tekki-tom/mqtt_io/i2c_messung/i2c_extender_mcp23017_messbericht.pdf

## April 21, 2023

## 1 Systemaufbau

Das System ist auf einer Experimentiersteckbrett (Breadboard) aufgebaut.
Der IO expander ist ein Microchip MCP 23017. Die Adresse ist auf 0 (0x20) festgelegt (A0 bis A2 auf GND). Die Bus-Leitungen (SCK, SDA) sind am MCP 23017 nicht mit pull ups auf VCC gezogen. Am Pico sind die internen pullup-Widerst¨ande aktiviert (siehe Listing3.)
An b0 ist ein BC550 angeschlossen, daran ein Finder 52.09.012 Relais. Das Relais ist an +12V (a0) angeschlossen, a1 ist am Kollektor des BC550 angeschlossen, der Emitter des BC550 ist an GND.
Die Tests sollen einen Einsatz als IO-Expander f¨ur einen Raspberry Pi vorbereiten. Interessante Infos sind hier: https://netzmafia.ee.hm.edu/skripten/hardware/RasPi/Projekt-I2C-Expander/index.html

## 2 Test Pi Pico

Als Testger¨at wird ein Raspberry Pi Pico W eingesetzt.
Der Extender ist an Pin 38 mit GND verbunden, Pin 36 mit 3,3V.
Das Testprogramm initialisiert den Bus i2c an den default-Pins (CSK an Pin 7 / GP5, SDA an Pin 6 / GP4).
allgemeine Inits:
in main:
Anschließend sendet das Programm die Befehlsfolge:

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

3 #i n cl u d e ” hardware / i 2 c . h”
#i n cl u d e ” pi c o / cyw43 arch . h” Listing 1: Includes (Pi Pico)

1

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

2

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

20
p r i n t f ( ” i 2 c l e d o f f r e s u l t : %d\n” , r e s u l t ) ;
22 | g pi o p u t (LED PIN , 0 ) ;
| c yw 4 3 a r c h g pi o p u t (CYW43 WL GPIO LED PIN, 0 ) ;
24 | sl e e p m s ( 1 0 0 0 ) ;
| p r i n t f ( ” bli n k \n” ) ;
26 | }
| Listing 5: Endlosschleife. Schaltet a0 und b0 zyklisch ein und aus

und initialisiert damit die Ports a und b als Ausg¨ange (alle Pins). mit printf (”i2c result : %d\n”, result); wird via Terminal ( minicom -b 115200 -o -D /dev/ttyACM0 ) die R¨uckmeldung des
i2c-Bus ausgegeben. 2 = okay, 254 = nok.
In einer Endlosschleife werden dann die Pins a0 und b0 wechselnd auf 1 und 0
gesetzt: Das Ergebnis auf dem Bus zeigt Bild 1. Im Bild sind die Register 0x12 und 0x13 adressiert, dies ist im Script in 0x14 und 0x15 korrigiert.
Der Test war ¨uberwiegend erfolgreich verlaufen. Wenn durch einen Wackelkontakt Pin SCK oder SDA unterbrochen wurde, wurde der Kontakt nicht wieder hergestellt. Es musste durch trennen der Versorgung des Pico und ca. 30 - 60 sec. Warten das System neu initialisiert werden.

### 2.1 Zweiter Test Pi Pico

Testaufbau: Sender Pi Pico, Programm wie oben. Empf¨anger: 2x MCP 23017. Ein Expander (links) auf Adr. 0x20, der andere auf Adr. Oszilloskop

3

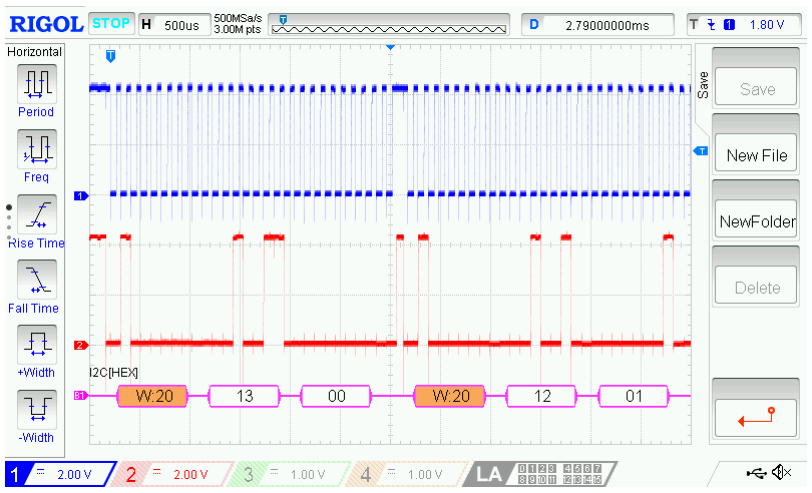
[picture p1: figure]

Figure 1: Ausgabe des I2C-Bus (Adr. 0x20, Register 0x13 und 0x12 sind im Code auf 0x15 und 0x14 korrigiert)

Kanal 1 SCK an Pico,

Kanal 2 SDA an Pico,

Kanal 3 SCK an Expander links (0x22),

Kanal 4 SDA an Expander links (0x22)

Der Expander links l¨asst sich nicht korrekt ansprechen. Das Signal am Pico ist in Ordnung, beim Signal am Expander links fehlt bei einigen Tests SCK.
Einspeisung erfolgt zuerst am Expander links. Dann am Expander rechts. Bei Einspeisung rechts ist links ist zeitweise kein SCK messbar.
Nach Vertauschen der Reihenfolge im Programm (zuerst an 0x22, dann 0x20) reagiert der Expander 0x22 auch nicht. siehe Bild 2
Bei beiden Expandern /Reset auf VCC gezogen, das behebt das Problem, von undefinierten ausf¨allen. Vorher war /Reset nicht beschaltet.

## 3 Test Pi 3b+

Als Pi wird ein Raspberry Pi 3b+ mit Raspian verwendet. Am Pi ist der i2c Bus aktiviert. zum Testen ist der Takt des i2c auf 1kHz begrenzt. Bei Messung mit dem Oszilloskop (Rigol DS 1054Z) ergibt sich, dass der Takt bei 100kHz bleibt (siehe Bild 3).

4

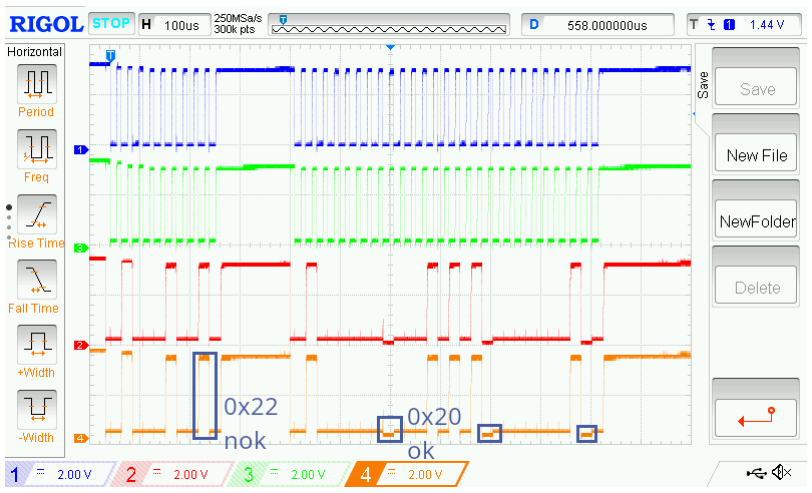
[picture p2: figure]

Figure 2: Zwei Expander. Sende Reihenfolge 0x22, dann 0x20

Ein Test mit i2cdetect =y 1 0x20 0x27 ergab folgende Situation: siehe Bild 3 An der Adresse 0x20 antwortete der IC planm¨aßig. An Adresse 0x21 kam keine Antwort (gekennzeichnet durch das ”‘?”’) danach bricht das Signal unerwartet zusammen. Diese Zusammenbr¨uche sind bei Test mit dem Raspberry Pi mehrfach festzustellen, eine Ursache ist mir noch nicht bekannt. Ein erneuter Test mit detect ergab Bild 4. Der Expander konnte die Adresse nicht dekodieren und der Detect schlug damit fehl.

5

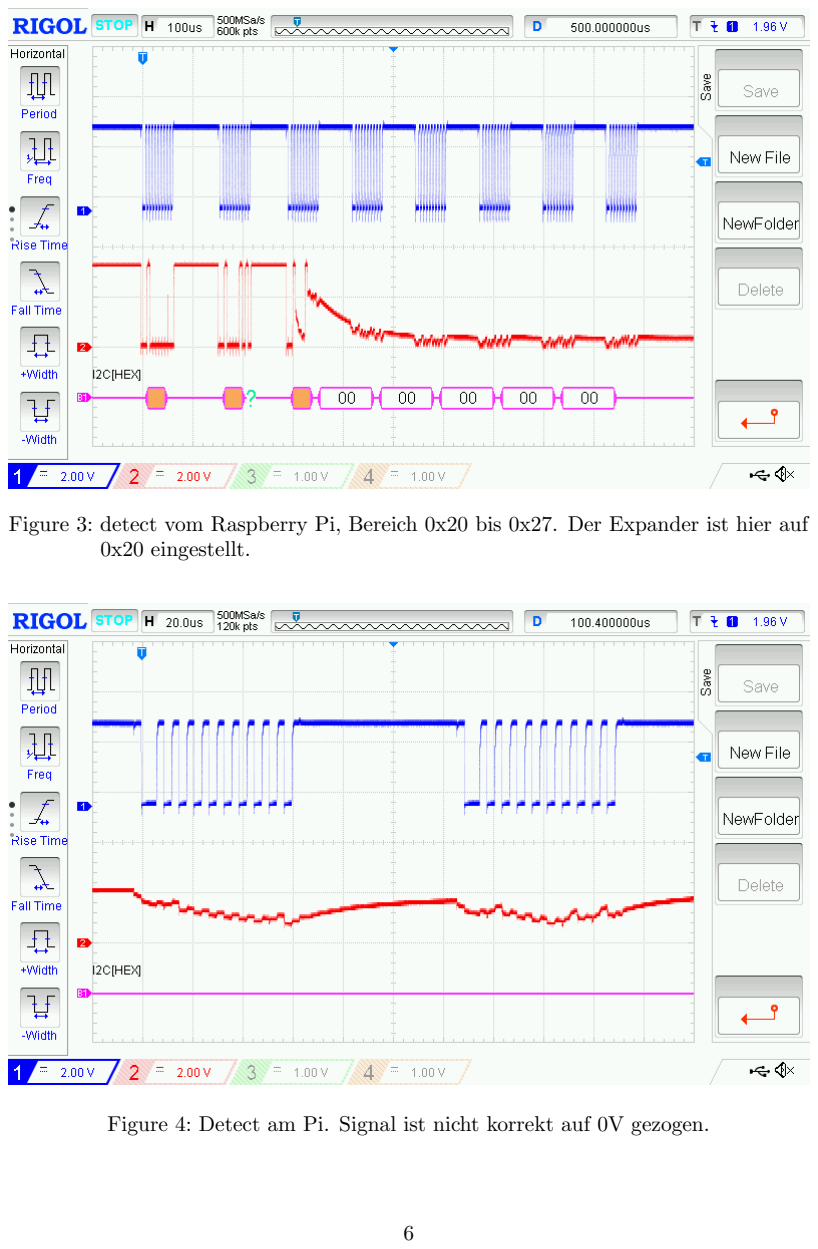
[picture p3: page 6]

Figure 3: detect vom Raspberry Pi, Bereich 0x20 bis 0x27. Der Expander ist hier auf 0x20 eingestellt.

Figure 4: Detect am Pi. Signal ist nicht korrekt auf 0V gezogen.

6
