tekki-tom/mqtt_io/mqtt_io/mqtt_out_box/mqtt_out_box_thd/mqtt_out_box_thd_sch.pdf

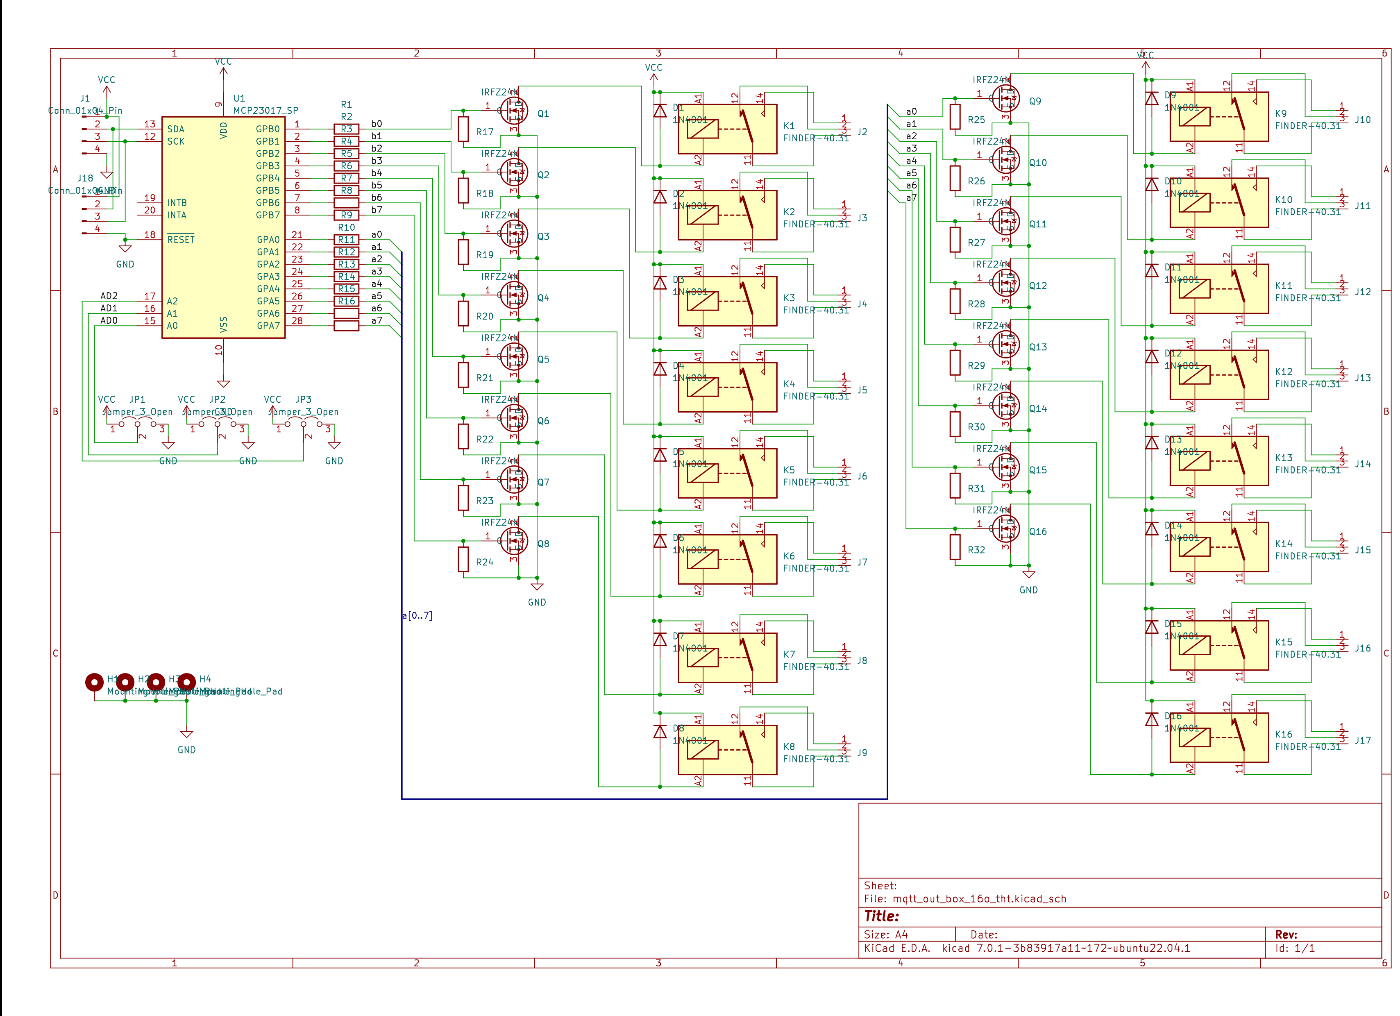
[picture p4: page 1]
