tekki-tom/mqtt_io/i2c_messung/pico_2exp_0x20_nok._mark.png

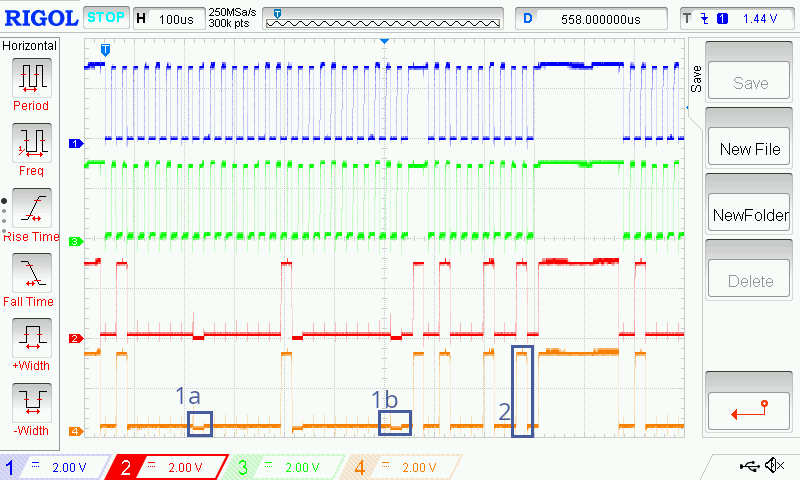
i2c_messung/pico_2exp_0x20_nok._mark.png
