tekki-tom/mqtt_io/mqtt_io/out/mqtt_out_box_16o_tht/rev2/mqtt_out_box_16o_tht_rev2.kicad_pro/todo.md

#Todos

09.09.23

* [x] Pullup-Widerstände von SCL und SDA per Jumper schaltbar machen (pullUp aktiv/inaktiv)
* [x] Prüfen ob SDA und SCL von Data in auf Data out vertauscht sind
