tekki-tom/mqtt_io/mqtt_io/mqtt_out_box/mqtt_out_box_thd/mqtt_out_box_thd_brd_parts.pdf

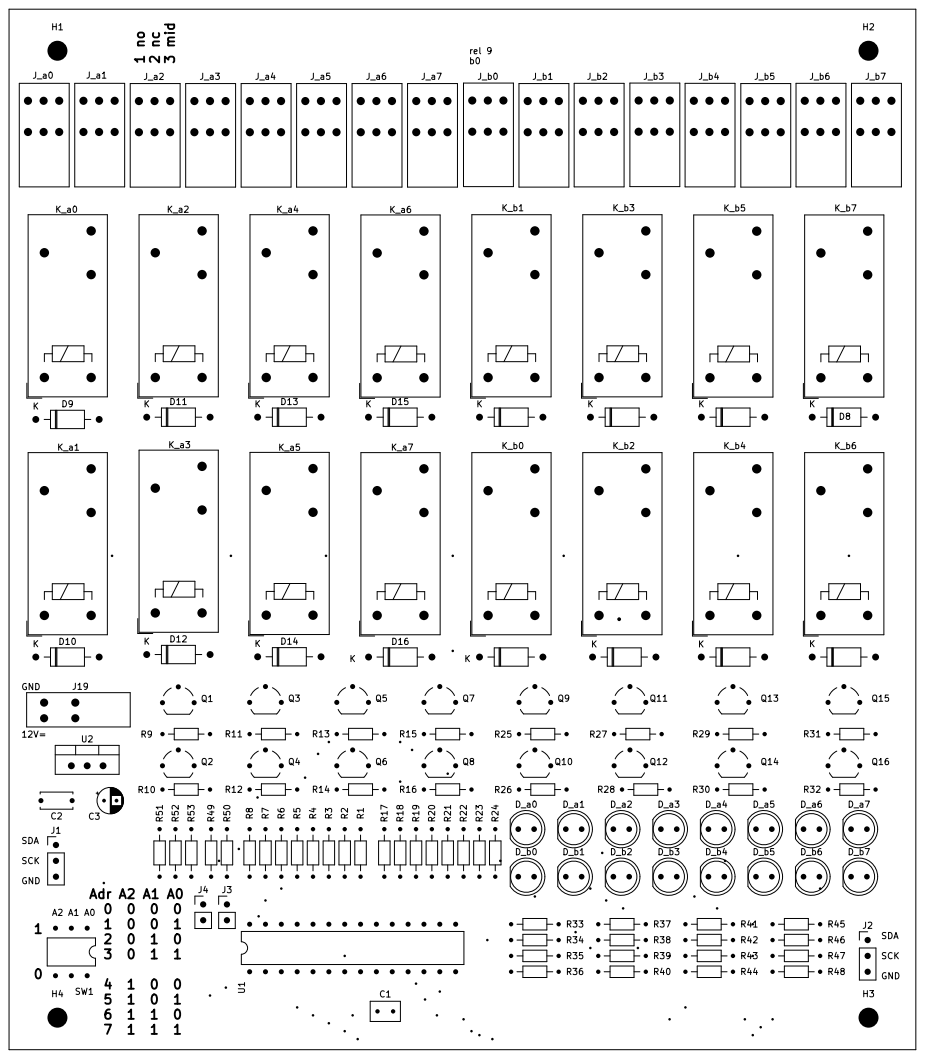
[picture p7: page 1]
