tekki-tom/mqtt_io/mqtt_io/in/mqtt_io_in_box_16i_tht_smd/mqtt_io_in_box_16i_tht_smd_schaltplan.pdf

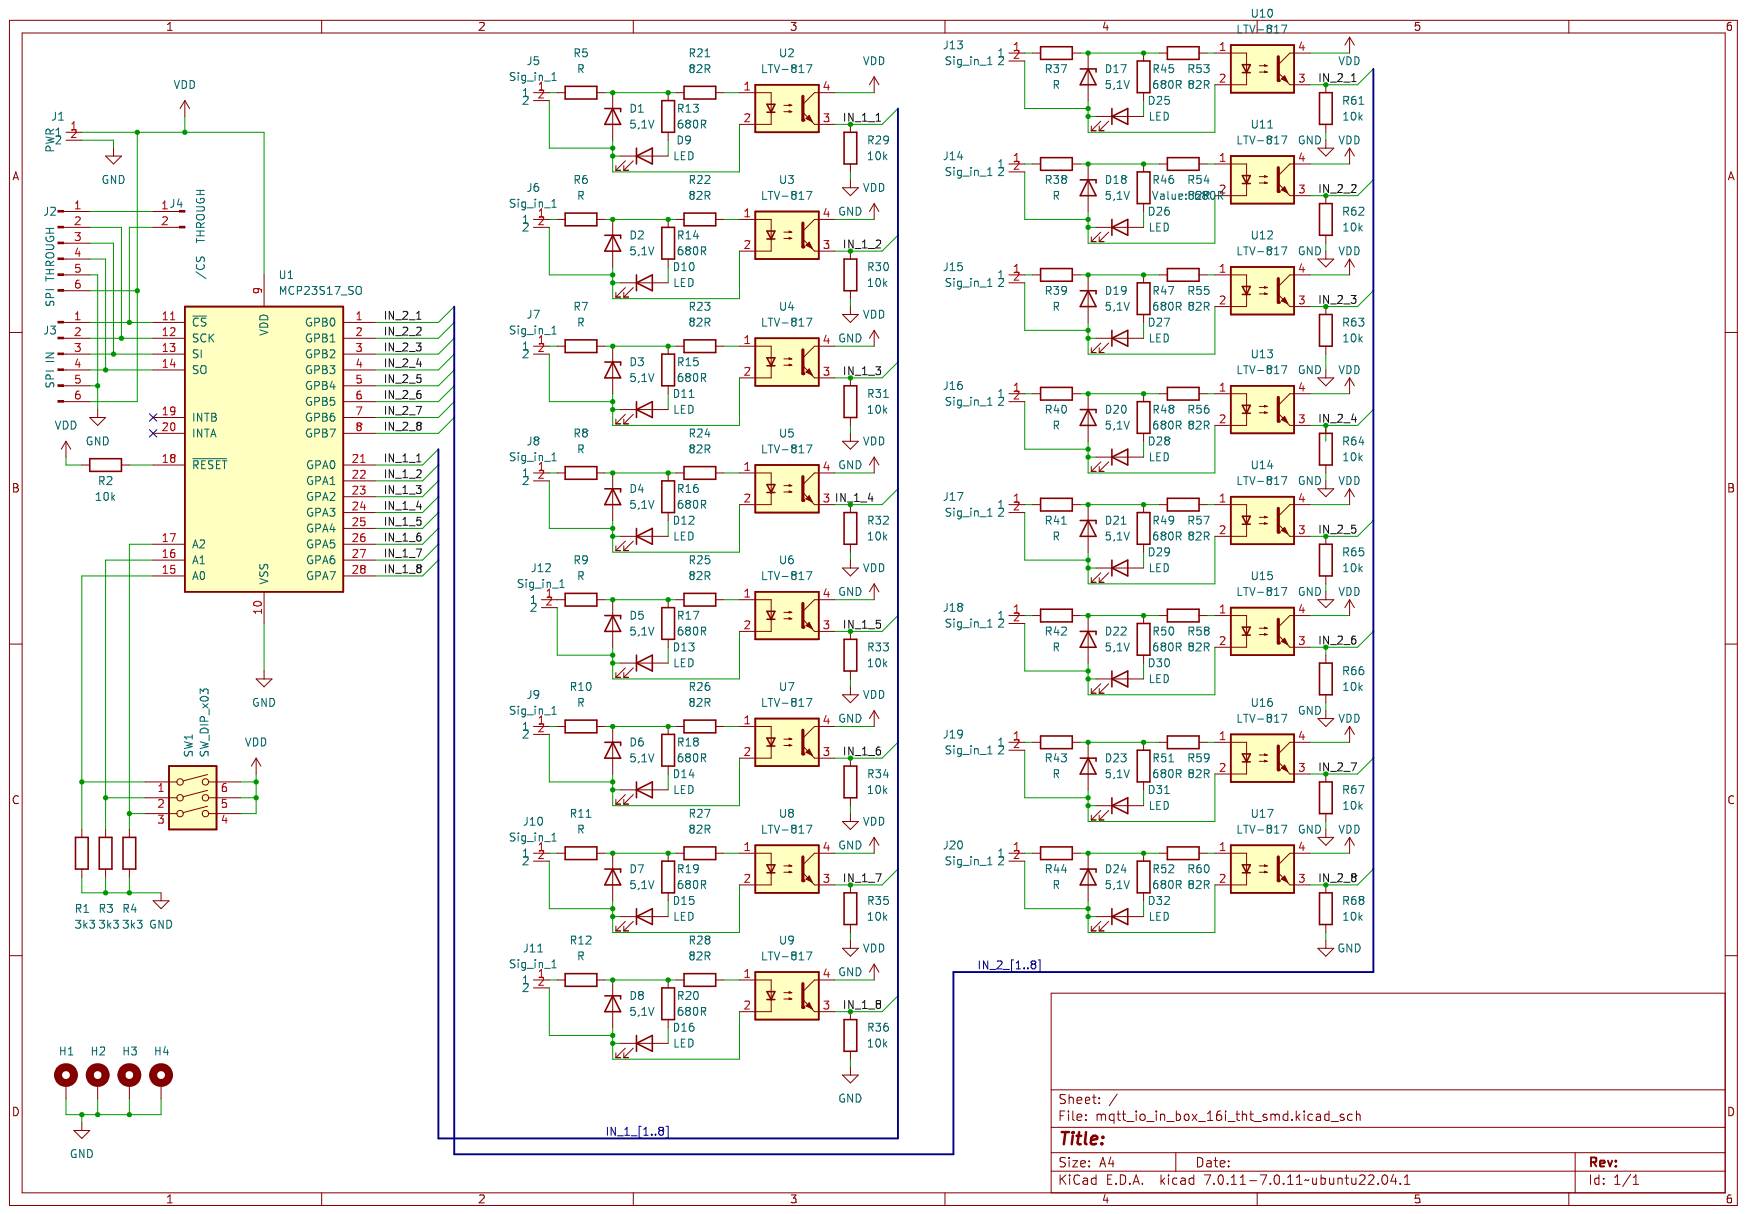
[picture p9: page 1]
