tekki-tom/mqtt_io/mqtt_io/mqtt_out_box/mqtt_out_box_thd/mqtt_out_box_thd_brd_cu_f.pdf

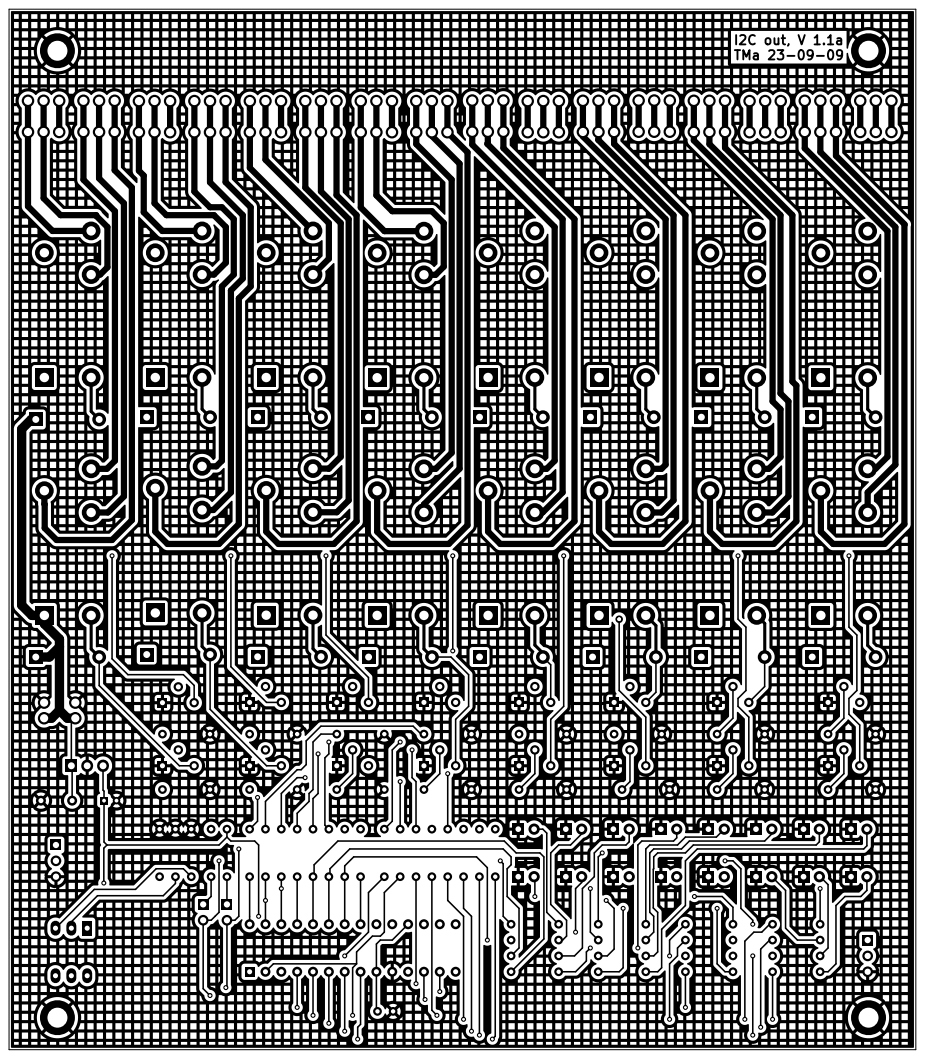
[picture p11: page 1]
