tekki-tom/mqtt_io/mqtt_io/mqtt_out_box/mqtt_out_box_thd/mqtt_out_mics_red_white_v0_1_tma.pdf

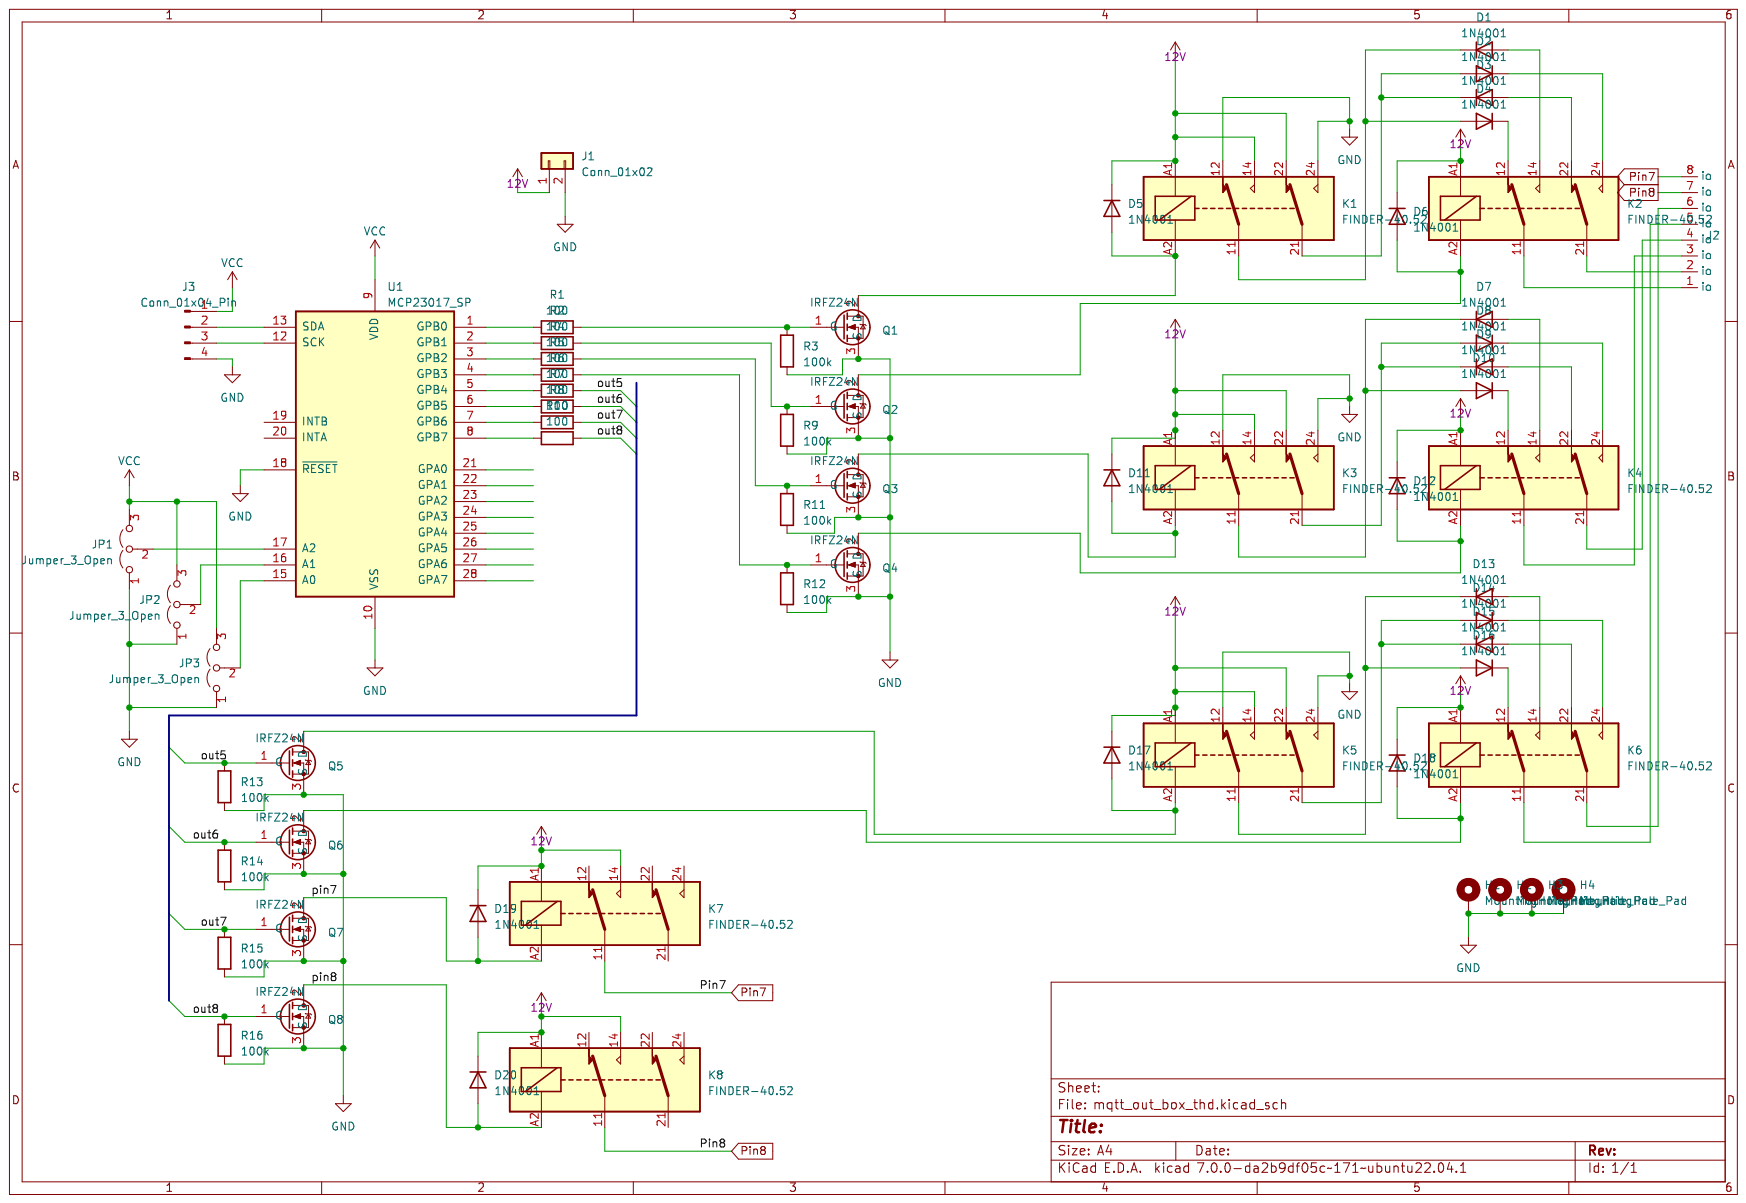
[picture p12: page 1]
