tekki-tom/mqtt_io/mqtt_io/out/mqtt_out_box_16o_tht/mqtt_out_box_16out_tht_board_cu.pdf

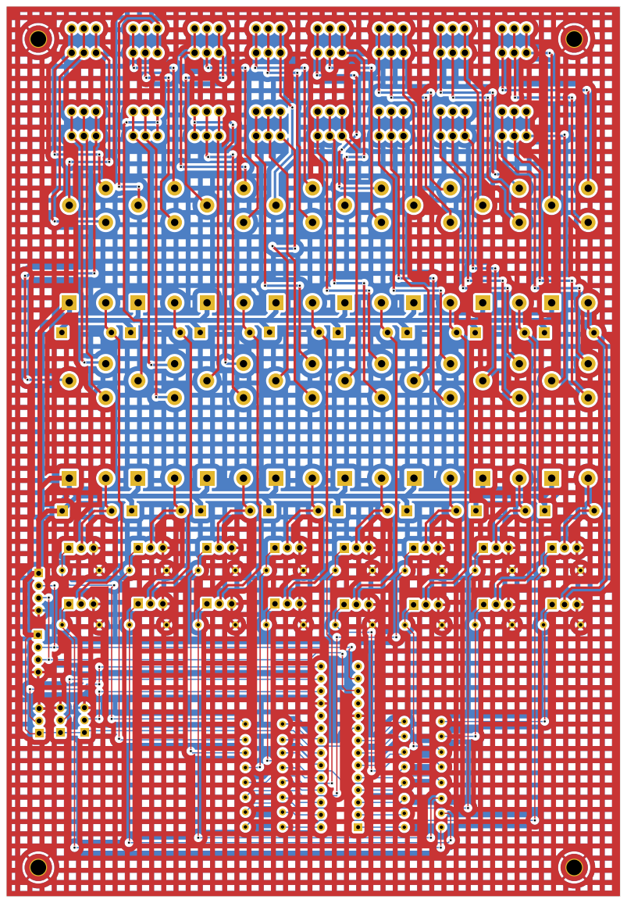
[picture p13: page 1]
