tekki-tom/mqtt_io/mqtt_io/in/mqtt_io_in_box_16i_tht_smd/mqtt_io_in_box_16i_tht_smd.kicad_pcb

## KiCad design mqtt_io/in/mqtt_io_in_box_16i_tht_smd/mqtt_io_in_box_16i_tht_smd.kicad_pcb (2024-04-09)

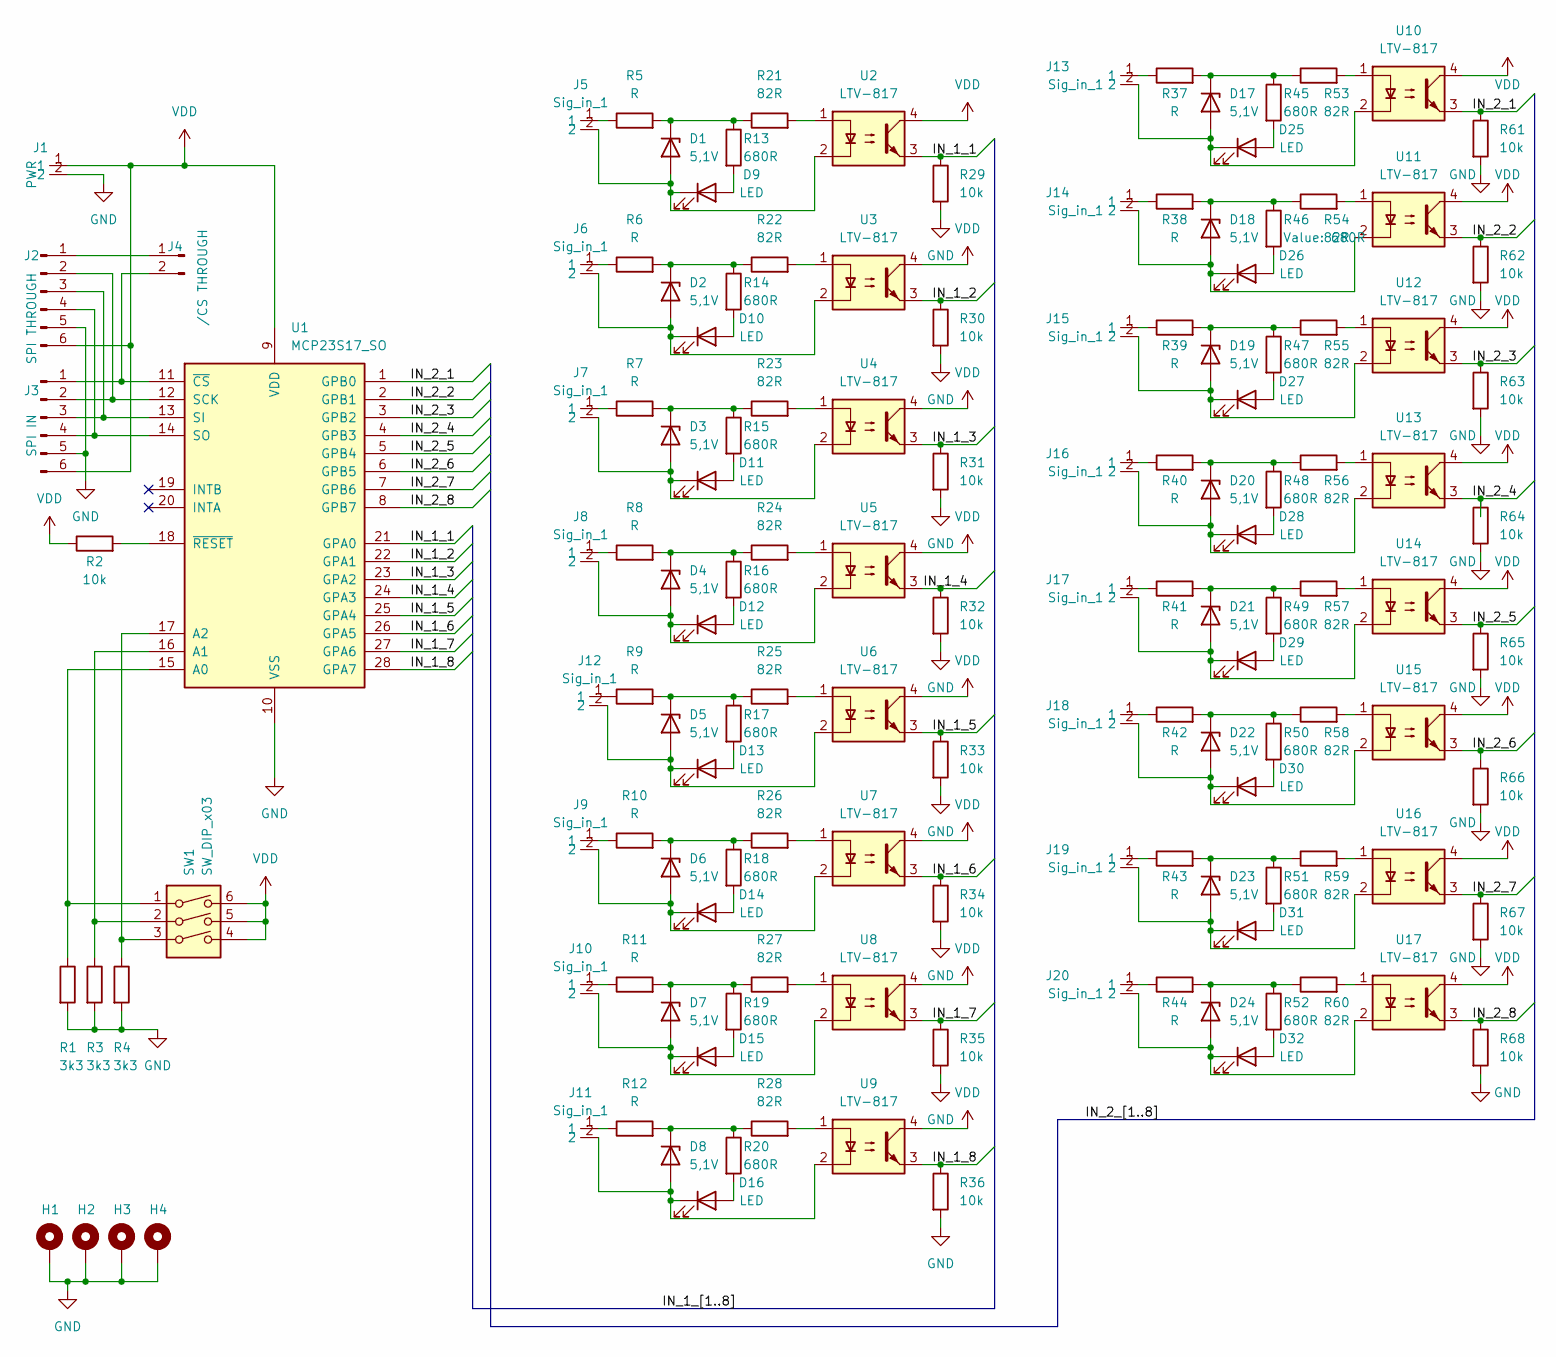
[picture p14: schematic mqtt_io_in_box_16i_tht_smd.kicad_sch]

Parts:
D1, D2, D3, D4, D5, D6, D7, D8, D17, D18, D19, D20, D21, D22, D23, D24: 5,1V; D_MiniMELF_Handsoldering
D9, D10, D11, D12, D13, D14, D15, D16, D25, D26, D27, D28, D29, D30, D31, D32: LED; LED_0805_2012Metric_Pad1.15x1.40mm_HandSolder
H1, H2, H3, H4: MountingHole_Pad; MountingHole_3.2mm_M3_DIN965_Pad_TopBottom
J1: PWR; AST_041-2
J2: SPI THROUGH; PinHeader_1x06_P2.54mm_Vertical
J3: SPI IN; PinHeader_1x06_P2.54mm_Vertical
J4: /CS THROUGH; PinHeader_1x02_P2.54mm_Vertical
J5, J6, J7, J8, J9, J10, J11, J12, J13, J14, J15, J16, J17, J18, J19, J20: Sig_in_1; AST_041-2
R1, R3, R4: 3k3; R_0805_2012Metric_Pad1.20x1.40mm_HandSolder
R2, R29, R30, R31, R32, R33, R34, R35, R36, R61, R62, R63, R64, R65, R66, R67, R68: 10k; R_0805_2012Metric_Pad1.20x1.40mm_HandSolder
R5, R6, R7, R8, R9, R10, R11, R12, R37, R38, R39, R40, R41, R42, R43, R44: R; R_0805_2012Metric_Pad1.20x1.40mm_HandSolder
R13, R14, R15, R16, R17, R18, R19, R20, R45, R46, R47, R48, R49, R50, R51, R52: 680R; R_0805_2012Metric_Pad1.20x1.40mm_HandSolder
R21, R22, R23, R24, R25, R26, R27, R28, R53, R54, R55, R56, R57, R58, R59, R60: 82R; R_0805_2012Metric_Pad1.20x1.40mm_HandSolder
SW1: SW_DIP_x03; DIP-6_W7.62mm_LongPads
U1: MCP23S17_SO; SOIC-28W_7.5x17.9mm_P1.27mm
U2, U3, U4, U5, U6, U7, U8, U9, U10, U11, U12, U13, U14, U15, U16, U17: LTV-817; DIP-4_W7.62mm

Connections:
/IN_1_1: R29.1, U1.21 (GPA0), U2.3
/IN_1_2: R30.1, U1.22 (GPA1), U3.3
/IN_1_3: R31.1, U1.23 (GPA2), U4.3
/IN_1_4: R32.1, U1.24 (GPA3), U5.3
/IN_1_5: R33.1, U1.25 (GPA4), U6.3
/IN_1_6: R34.1, U1.26 (GPA5), U7.3
/IN_1_7: R35.1, U1.27 (GPA6), U8.3
/IN_1_8: R36.1, U1.28 (GPA7), U9.3
/IN_2_1: R61.1, U1.1 (GPB0), U10.3
/IN_2_2: R62.1, U1.2 (GPB1), U11.3
/IN_2_3: R63.1, U1.3 (GPB2), U12.3
/IN_2_4: R64.1, U1.4 (GPB3), U13.3
/IN_2_5: R65.1, U1.5 (GPB4), U14.3
/IN_2_6: R66.1, U1.6 (GPB5), U15.3
/IN_2_7: R67.1, U1.7 (GPB6), U16.3
/IN_2_8: R68.1, U1.8 (GPB7), U17.3
GND: H1.1, H2.1, H3.1, H4.1, J1.2, J2.5, J3.5, R1.2, R3.2, R4.2, R29.2, R30.2, R31.2, R32.2, R33.2, R34.2, R35.2, R36.2, R61.2, R62.2, R63.2, R64.2, R65.2, R66.2, R67.2, R68.2, U1.10 (VSS)
unnamed: D1.2 (A), D9.1 (K), J5.2, U2.2
unnamed: D1.1 (K), R5.2, R13.1, R21.1
unnamed: D2.1 (K), R6.2, R14.1, R22.1
unnamed: D3.1 (K), R7.2, R15.1, R23.1
unnamed: D4.1 (K), R8.2, R16.1, R24.1
unnamed: D5.1 (K), R9.2, R17.1, R25.1
unnamed: D6.1 (K), R10.2, R18.1, R26.1
unnamed: D7.1 (K), R11.2, R19.1, R27.1
unnamed: D8.1 (K), R12.2, R20.1, R28.1
unnamed: D9.2 (A), R13.2
unnamed: D10.2 (A), R14.2
unnamed: D2.2 (A), D10.1 (K), J6.2, U3.2
unnamed: D11.2 (A), R15.2
unnamed: D3.2 (A), D11.1 (K), J7.2, U4.2
unnamed: D12.2 (A), R16.2
unnamed: D4.2 (A), D12.1 (K), J8.2, U5.2
unnamed: D13.2 (A), R17.2
unnamed: D5.2 (A), D13.1 (K), J12.2, U6.2
unnamed: D14.2 (A), R18.2
unnamed: D6.2 (A), D14.1 (K), J9.2, U7.2
unnamed: D15.2 (A), R19.2
unnamed: D7.2 (A), D15.1 (K), J10.2, U8.2
unnamed: D16.2 (A), R20.2
unnamed: D8.2 (A), D16.1 (K), J11.2, U9.2
unnamed: D17.2 (A), D25.1 (K), J13.2, U10.2
unnamed: D17.1 (K), R37.2, R45.1, R53.1
unnamed: D18.2 (A), D26.1 (K), J14.2, U11.2
unnamed: D18.1 (K), R38.2, R46.1, R54.1
unnamed: D19.2 (A), D27.1 (K), J15.2, U12.2
unnamed: D19.1 (K), R39.2, R47.1, R55.1
unnamed: D20.2 (A), D28.1 (K), J16.2, U13.2
unnamed: D20.1 (K), R40.2, R48.1, R56.1
unnamed: D21.2 (A), D29.1 (K), J17.2, U14.2
unnamed: D21.1 (K), R41.2, R49.1, R57.1
unnamed: D22.2 (A), D30.1 (K), J18.2, U15.2
unnamed: D22.1 (K), R42.2, R50.1, R58.1
unnamed: D23.2 (A), D31.1 (K), J19.2, U16.2
unnamed: D23.1 (K), R43.2, R51.1, R59.1
unnamed: D24.2 (A), D32.1 (K), J20.2, U17.2
unnamed: D24.1 (K), R44.2, R52.1, R60.1
unnamed: D25.2 (A), R45.2
unnamed: D26.2 (A), R46.2
unnamed: D27.2 (A), R47.2
unnamed: D28.2 (A), R48.2
unnamed: D29.2 (A), R49.2
unnamed: D30.2 (A), R50.2
unnamed: D31.2 (A), R51.2
unnamed: D32.2 (A), R52.2
unnamed: J2.1, J4.1
unnamed: J2.2, J3.2, U1.12 (SCK)
unnamed: J2.3, J3.3, U1.13 (SI)
unnamed: J2.4, J3.4, U1.14 (SO)
unnamed: J3.1, J4.2, U1.11 (~CS)
unnamed: J5.1, R5.1
unnamed: J6.1, R6.1
unnamed: J7.1, R7.1
unnamed: J8.1, R8.1
unnamed: J9.1, R10.1
unnamed: J10.1, R11.1
unnamed: J11.1, R12.1
unnamed: J12.1, R9.1
unnamed: J13.1, R37.1
unnamed: J14.1, R38.1
unnamed: J15.1, R39.1
unnamed: J16.1, R40.1
unnamed: J17.1, R41.1
unnamed: J18.1, R42.1
unnamed: J19.1, R43.1
unnamed: J20.1, R44.1
unnamed: R21.2, U2.1
unnamed: R22.2, U3.1
unnamed: R23.2, U4.1
unnamed: R24.2, U5.1
unnamed: R25.2, U6.1
unnamed: R26.2, U7.1
unnamed: R27.2, U8.1
unnamed: R28.2, U9.1
unnamed: R53.2, U10.1
unnamed: R54.2, U11.1
unnamed: R55.2, U12.1
unnamed: R56.2, U13.1
unnamed: R57.2, U14.1
unnamed: R58.2, U15.1
unnamed: R59.2, U16.1
unnamed: R60.2, U17.1
unnamed: R1.1, SW1.1, U1.15 (A0)
unnamed: R3.1, SW1.2, U1.16 (A1)
unnamed: R4.1, SW1.3, U1.17 (A2)
unnamed: R2.2, U1.18 (~RESET)
VDD: J1.1, J2.6, J3.6, R2.1, SW1.4, SW1.5, SW1.6, U1.9 (VDD), U2.4, U3.4, U4.4, U5.4, U6.4, U7.4, U8.4, U9.4, U10.4, U11.4, U12.4, U13.4, U14.4, U15.4, U16.4, U17.4

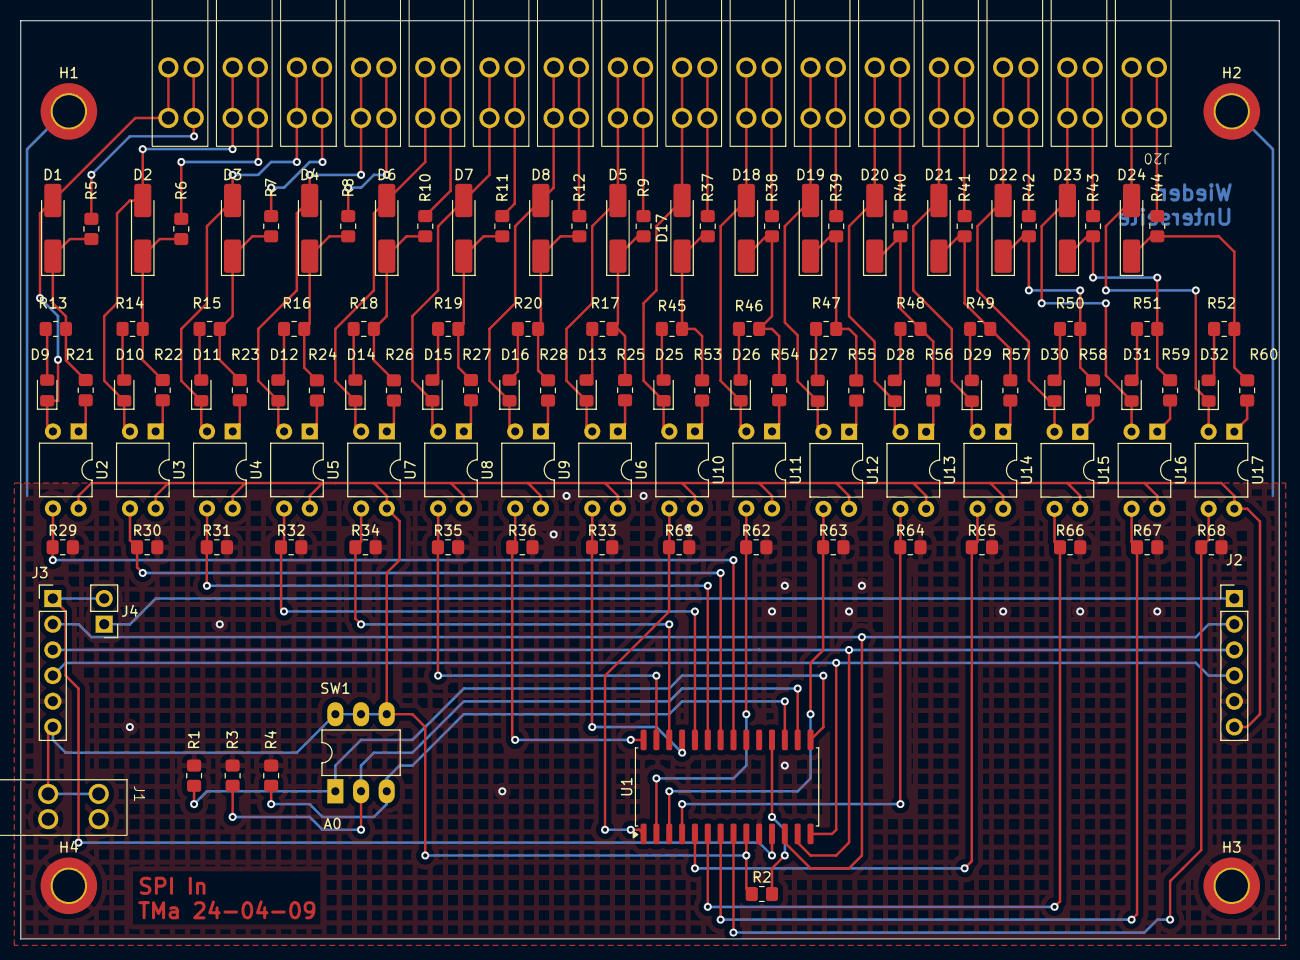
[picture p15: board mqtt_io_in_box_16i_tht_smd.kicad_pcb from above]

Board: 2 copper layers, 124.5 x 90.8 mm, 142 parts (0 on the bottom side), 107 nets.
