tekki-tom/mqtt_io/mqtt_io/mqtt_out_box/mqtt_out_box_thd/mqtt_out_box_thd.kicad_pcb

## KiCad design mqtt_io/mqtt_out_box/mqtt_out_box_thd/mqtt_out_box_thd.kicad_pcb (2023-04-23)

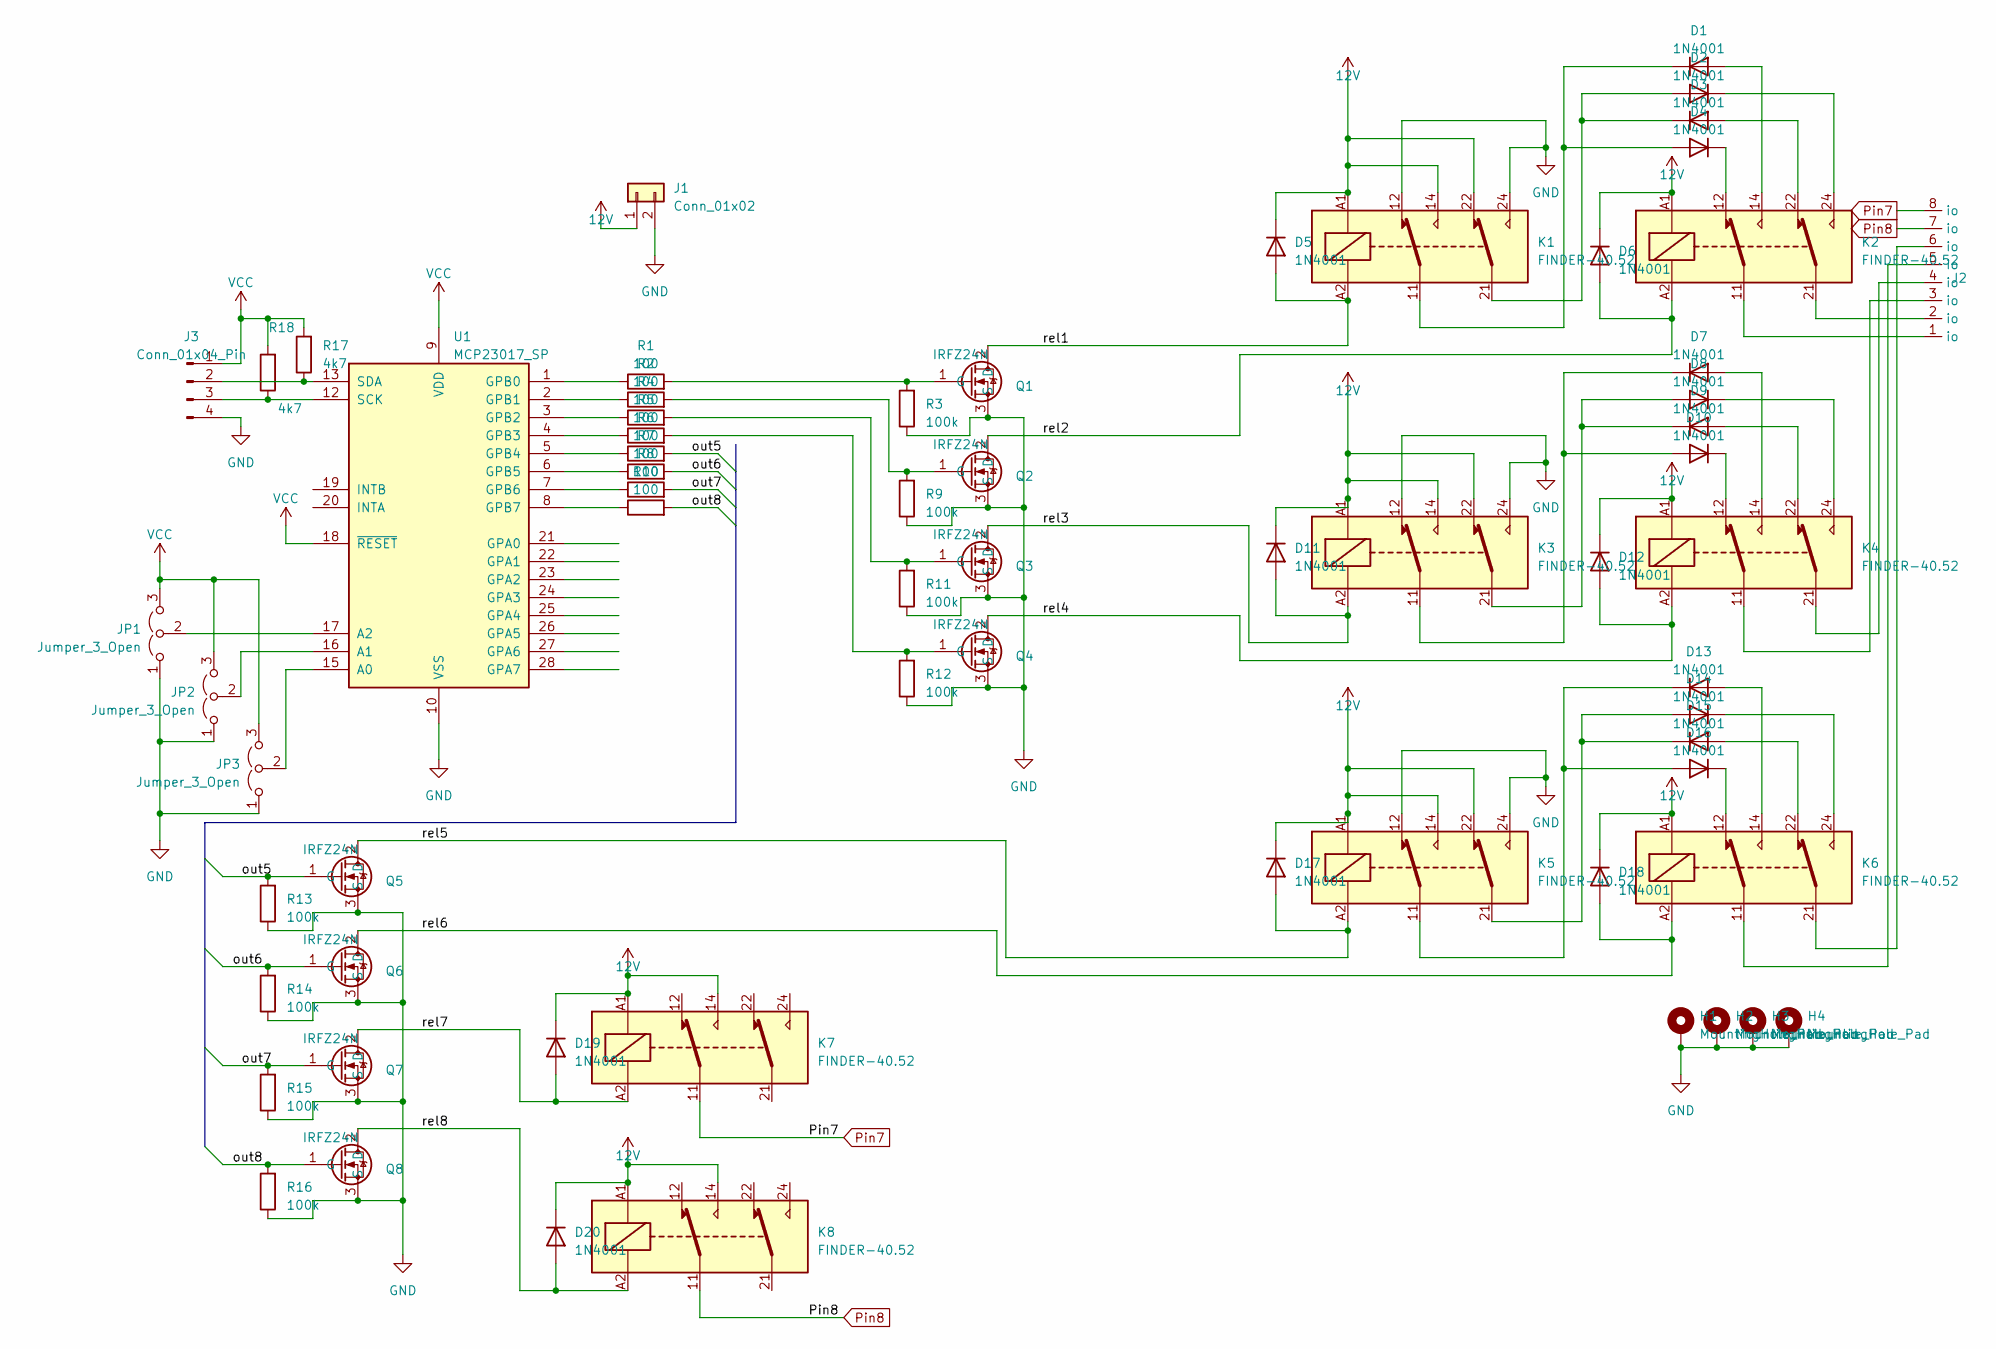
[picture p16: schematic mqtt_out_box_thd.kicad_sch]

Parts:
D1, D2, D3, D4, D5, D6, D7, D8, D9, D10, D11, D12, D13, D14, D15, D16, D17, D18, D19, D20: 1N4001; D_DO-41_SOD81_P10.16mm_Horizontal
H1, H2, H3, H4: MountingHole_Pad; MountingHole_3.2mm_M3_ISO7380_Pad_TopBottom
J1: Conn_01x02; PinHeader_1x02_P2.54mm_Vertical
J2: AST041-08
J3: Conn_01x04_Pin; PinHeader_1x04_P2.54mm_Vertical
JP1, JP2, JP3: Jumper_3_Open; PinHeader_1x03_P2.54mm_Vertical
K1, K2, K3, K4, K5, K6, K7, K8: FINDER-40.52; Relay_DPDT_Finder_40.52
Q1, Q2, Q3, Q4, Q5, Q6, Q7, Q8: IRFZ24N; TO-220-3_Vertical
R1, R2, R4, R5, R6, R7, R8, R10: 100; R_Axial_DIN0204_L3.6mm_D1.6mm_P7.62mm_Horizontal
R3, R9, R11, R12, R13, R14, R15, R16: 100k; R_Axial_DIN0204_L3.6mm_D1.6mm_P7.62mm_Horizontal
R17, R18: 4k7; R_Axial_DIN0204_L3.6mm_D1.6mm_P7.62mm_Horizontal
U1: MCP23017_SP; DIP-28_W7.62mm

Connections:
/out5: Q5.1 (G), R6.2, R13.2
/out6: Q6.1 (G), R7.2, R14.2
/out7: Q7.1 (G), R8.2, R15.2
/out8: Q8.1 (G), R10.2, R16.2
/rel1: D5.2 (A), K1.A2, Q1.2 (D)
/rel2: D6.2 (A), K2.A2, Q2.2 (D)
/rel3: D11.2 (A), K3.A2, Q3.2 (D)
/rel4: D12.2 (A), K4.A2, Q4.2 (D)
/rel5: D17.2 (A), K5.A2, Q5.2 (D)
/rel6: D18.2 (A), K6.A2, Q6.2 (D)
/rel7: D19.2 (A), K7.A2, Q7.2 (D)
/rel8: D20.2 (A), K8.A2, Q8.2 (D)
GND: H1.1, H2.1, H3.1, H4.1, J1.2, J3.4, JP1.1 (A), JP2.1 (A), JP3.1 (A), K1.12, K1.24, K3.12, K3.24, K5.12, K5.24, Q1.3 (S), Q2.3 (S), Q3.3 (S), Q4.3 (S), Q5.3 (S), Q6.3 (S), Q7.3 (S), Q8.3 (S), R3.1, R9.1, R11.1, R12.1, R13.1, R14.1, R15.1, R16.1, U1.10 (VSS)
unnamed: D1.2 (A), K2.14
unnamed: D1.1 (K), D4.2 (A), K1.11
unnamed: D2.2 (A), D3.1 (K), K1.21
unnamed: D2.1 (K), K2.24
unnamed: D3.2 (A), K2.22
unnamed: D4.1 (K), K2.12
unnamed: D7.2 (A), K4.14
unnamed: D8.2 (A), D9.1 (K), K3.21
unnamed: D8.1 (K), K4.24
unnamed: D9.2 (A), K4.22
unnamed: D7.1 (K), D10.2 (A), K3.11
unnamed: D10.1 (K), K4.12
unnamed: D13.2 (A), K6.14
unnamed: D13.1 (K), D16.2 (A), K5.11
unnamed: D14.2 (A), D15.1 (K), K5.21
unnamed: D14.1 (K), K6.24
unnamed: D15.2 (A), K6.22
unnamed: D16.1 (K), K6.12
unnamed: J2.1 (io), K2.11
unnamed: J2.2 (io), K2.21
unnamed: J2.3 (io), K4.11
unnamed: J2.4 (io), K4.21
unnamed: J2.5 (io), K6.11
unnamed: J2.6 (io), K6.21
unnamed: J3.2, R17.1, U1.13 (SDA)
unnamed: J3.3, R18.1, U1.12 (SCK)
unnamed: JP1.2 (C), U1.17 (A2)
unnamed: JP2.2 (C), U1.16 (A1)
unnamed: JP3.2 (C), U1.15 (A0)
unnamed: Q1.1 (G), R1.2, R3.2
unnamed: Q2.1 (G), R2.2, R9.2
unnamed: Q3.1 (G), R4.2, R11.2
unnamed: Q4.1 (G), R5.2, R12.2
unnamed: R1.1, U1.1 (GPB0)
unnamed: R2.1, U1.2 (GPB1)
unnamed: R4.1, U1.3 (GPB2)
unnamed: R5.1, U1.4 (GPB3)
unnamed: R6.1, U1.5 (GPB4)
unnamed: R7.1, U1.6 (GPB5)
unnamed: R8.1, U1.7 (GPB6)
unnamed: R10.1, U1.8 (GPB7)
Pin7: J2.8 (io), K7.11
Pin8: J2.7 (io), K8.11
VCC: J3.1, JP1.3 (B), JP2.3 (B), JP3.3 (B), R17.2, R18.2, U1.9 (VDD), U1.18 (~RESET)
VCCQ: D5.1 (K), D6.1 (K), D11.1 (K), D12.1 (K), D17.1 (K), D18.1 (K), D19.1 (K), D20.1 (K), J1.1, K1.14, K1.22, K1.A1, K2.A1, K3.14, K3.22, K3.A1, K4.A1, K5.14, K5.22, K5.A1, K6.A1, K7.14, K7.A1, K8.14, K8.A1

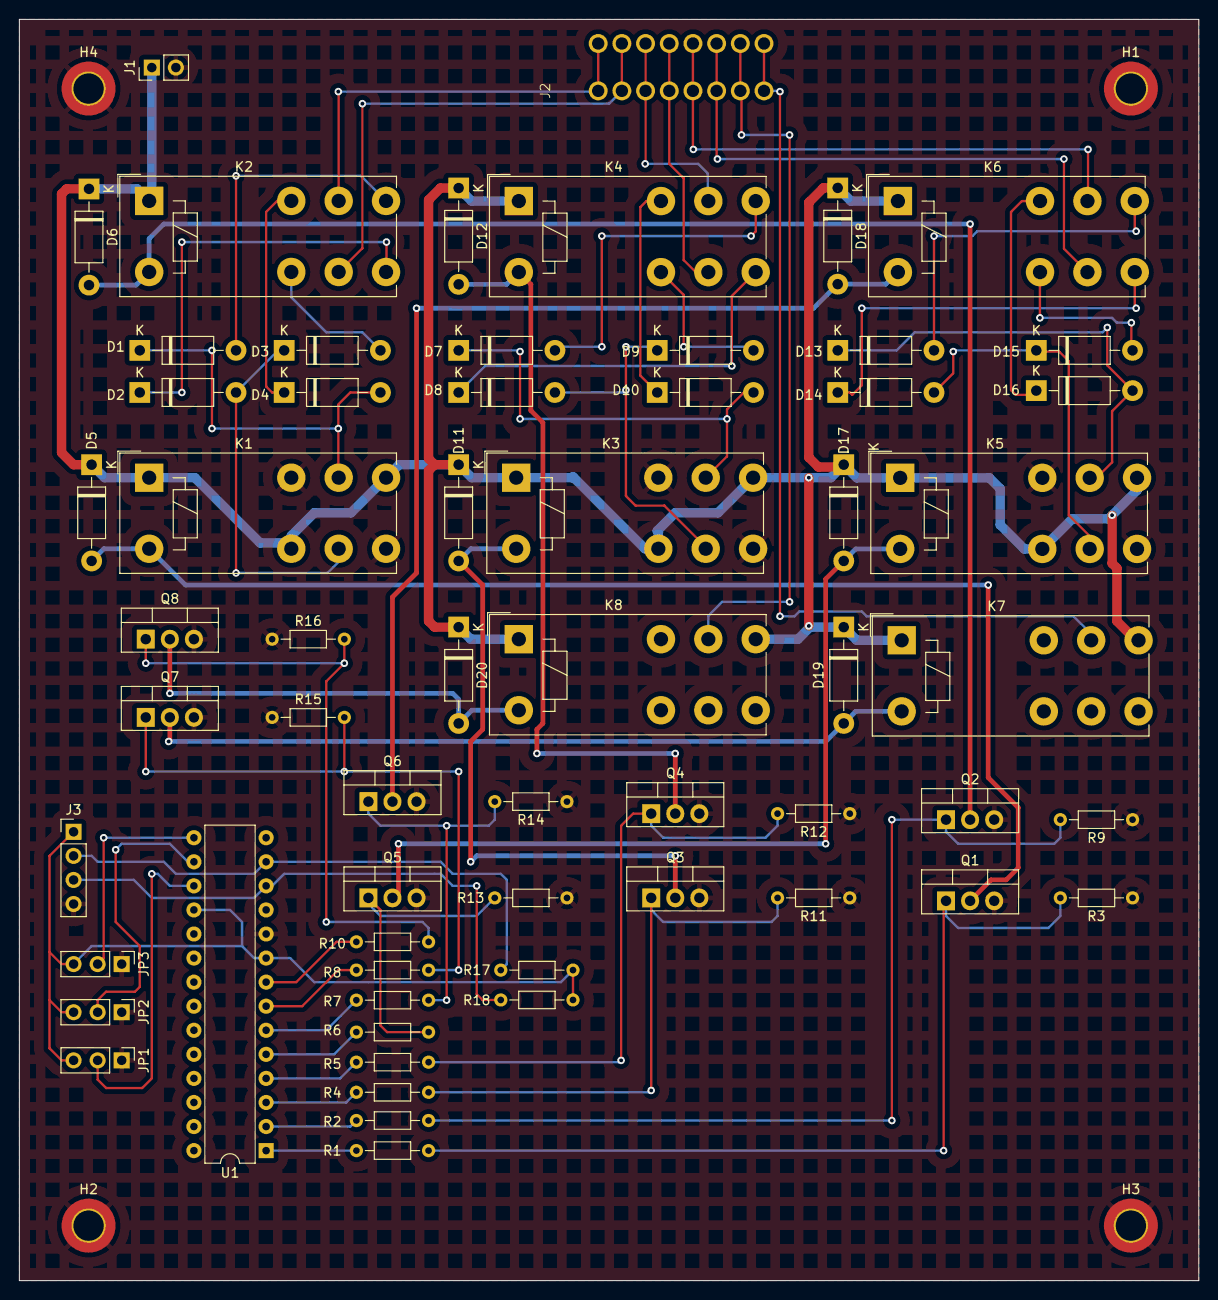
[picture p17: board mqtt_out_box_thd.kicad_pcb from above]

Board: 2 copper layers, 124.5 x 133.1 mm, 65 parts (0 on the bottom side), 58 nets.
