tekki-tom/mqtt_io/mqtt_io/out/mqtt_out_box_16o_smd/mqtt_out_box_16o.kicad_pcb

## KiCad design mqtt_io/out/mqtt_out_box_16o_smd/mqtt_out_box_16o.kicad_pcb (2023-04-23)

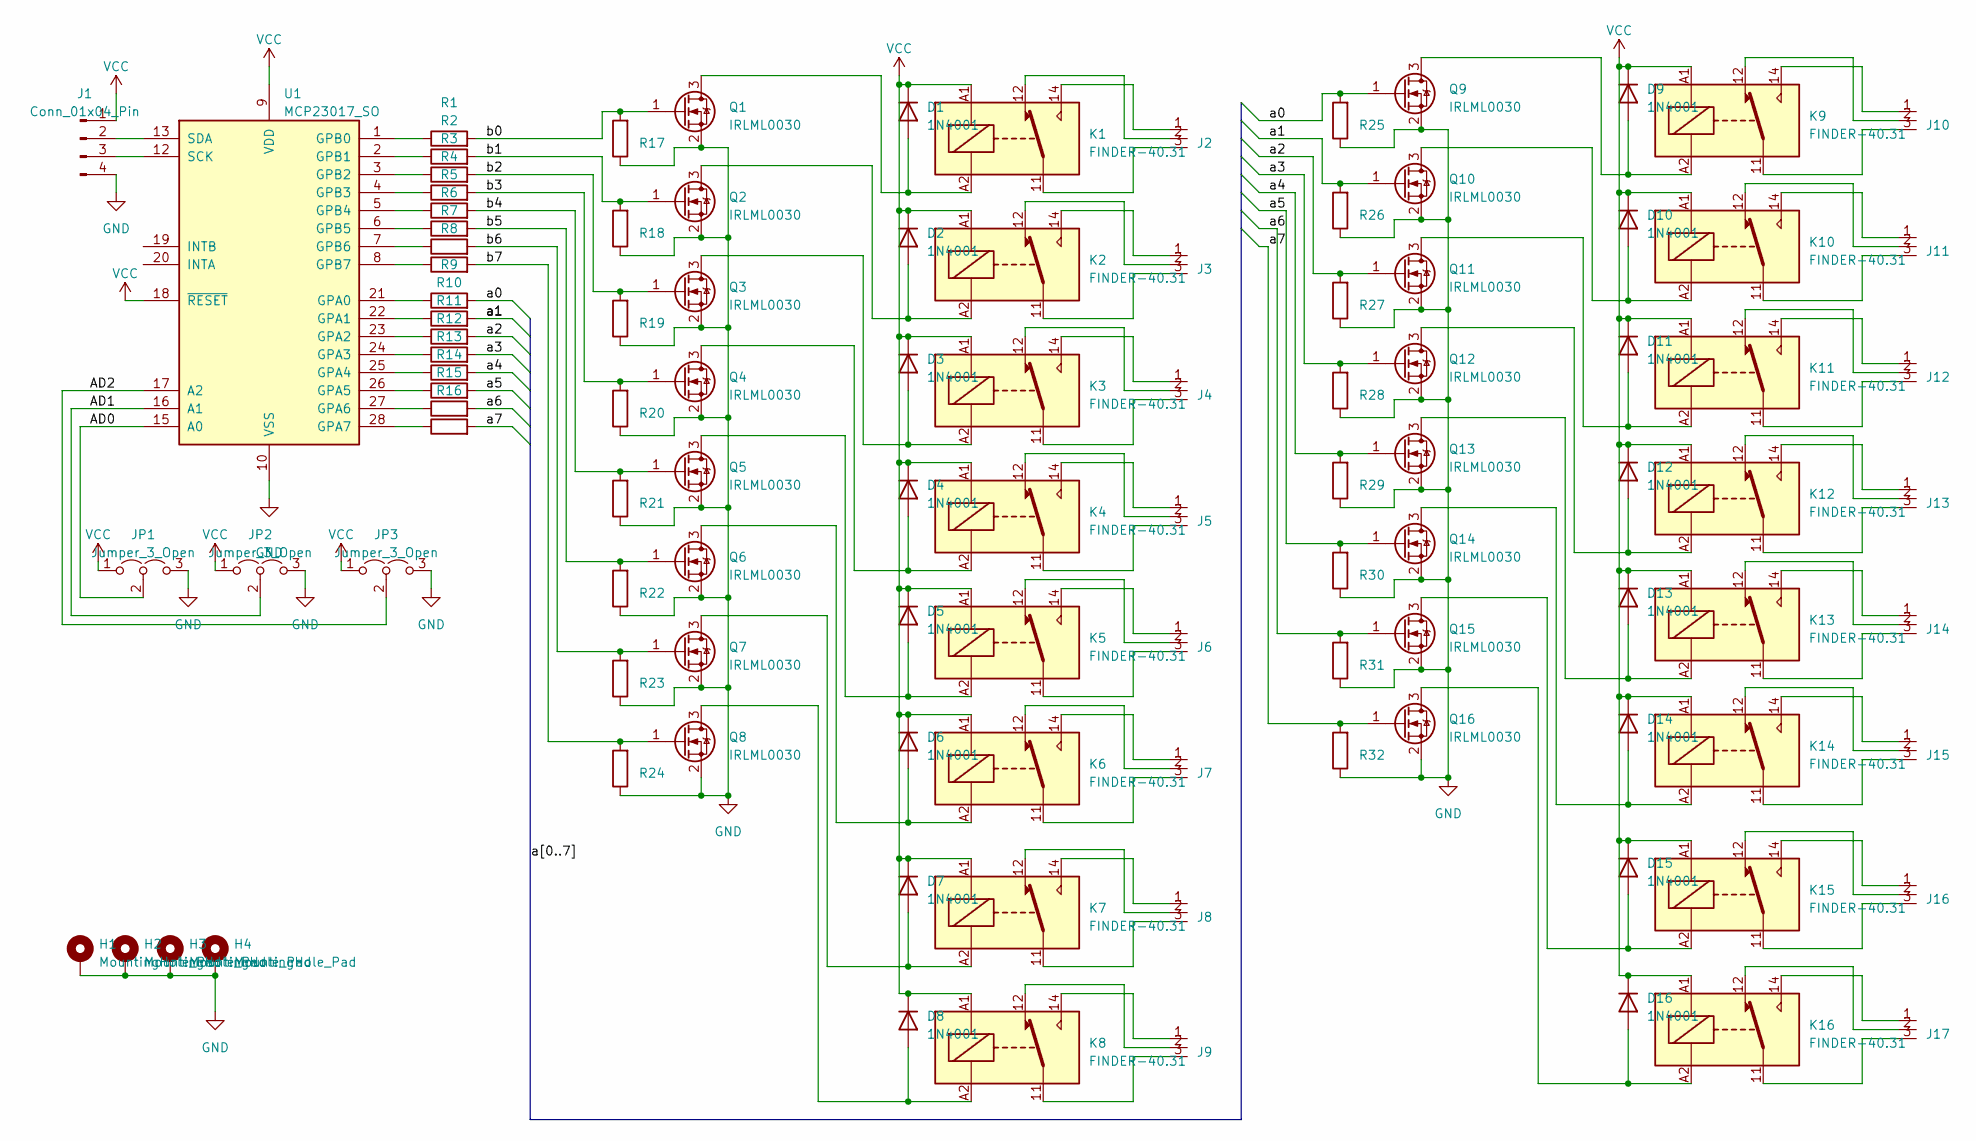
[picture p18: schematic mqtt_out_box_16o.kicad_sch]

Parts:
D1, D2, D3, D4, D5, D6, D7, D8, D9, D10, D11, D12, D13, D14, D15, D16: 1N4001; D_DO-41_SOD81_P10.16mm_Horizontal
H1, H2, H3, H4: MountingHole_Pad; MountingHole_3.2mm_M3_DIN965_Pad_TopBottom
J1: Conn_01x04_Pin; PinHeader_1x04_P2.54mm_Vertical
J2, J3, J4, J5, J6, J7, J8, J9, J10, J11, J12, J13, J14, J15, J16, J17: AST_041-3
JP1, JP2, JP3: Jumper_3_Open; PinHeader_1x03_P2.54mm_Vertical
K1, K2, K3, K4, K5, K6, K7, K8, K9, K10, K11, K12, K13, K14, K15, K16: FINDER-40.31; Relay_SPDT_Finder_40.31
Q1, Q2, Q3, Q4, Q5, Q6, Q7, Q8, Q9, Q10, Q11, Q12, Q13, Q14, Q15, Q16: IRLML0030; SOT-23
R1, R2, R3, R4, R5, R6, R7, R8, R9, R10, R11, R12, R13, R14, R15, R16: 100R; R_1206_3216Metric_Pad1.30x1.75mm_HandSolder
R17, R18, R19, R20, R21, R22, R23, R24, R25, R26, R27, R28, R29, R30, R31, R32: 100kR; R_1206_3216Metric_Pad1.30x1.75mm_HandSolder
U1: MCP23017_SO; SOIC-28W_7.5x17.9mm_P1.27mm

Connections:
/AD0: JP1.2 (C), U1.15 (A0)
/AD1: JP2.2 (C), U1.16 (A1)
/AD2: JP3.2 (C), U1.17 (A2)
/a0: Q9.1 (G), R9.2, R25.2
/a1: Q10.1 (G), R10.2, R26.2
/a2: Q11.1 (G), R11.2, R27.2
/a3: Q12.1 (G), R12.2, R28.2
/a4: Q13.1 (G), R13.2, R29.2
/a5: Q14.1 (G), R14.2, R30.2
/a6: Q15.1 (G), R15.2, R31.2
/a7: Q16.1 (G), R16.2, R32.2
/b0: Q1.1 (G), R1.2, R17.2
/b1: Q2.1 (G), R2.2, R18.2
/b2: Q3.1 (G), R3.2, R19.2
/b3: Q4.1 (G), R4.2, R20.2
/b4: Q5.1 (G), R5.2, R21.2
/b5: Q6.1 (G), R6.2, R22.2
/b6: Q7.1 (G), R7.2, R23.2
/b7: Q8.1 (G), R8.2, R24.2
GND: H1.1, H2.1, H3.1, H4.1, J1.4, JP1.3 (B), JP2.3 (B), JP3.3 (B), Q1.2 (S), Q2.2 (S), Q3.2 (S), Q4.2 (S), Q5.2 (S), Q6.2 (S), Q7.2 (S), Q8.2 (S), Q9.2 (S), Q10.2 (S), Q11.2 (S), Q12.2 (S), Q13.2 (S), Q14.2 (S), Q15.2 (S), Q16.2 (S), R17.1, R18.1, R19.1, R20.1, R21.1, R22.1, R23.1, R24.1, R25.1, R26.1, R27.1, R28.1, R29.1, R30.1, R31.1, R32.1, U1.10 (VSS)
unnamed: D1.2 (A), K1.A2, Q1.3 (D)
unnamed: D2.2 (A), K2.A2, Q2.3 (D)
unnamed: D3.2 (A), K3.A2, Q3.3 (D)
unnamed: D4.2 (A), K4.A2, Q4.3 (D)
unnamed: D5.2 (A), K5.A2, Q5.3 (D)
unnamed: D6.2 (A), K6.A2, Q6.3 (D)
unnamed: D7.2 (A), K7.A2, Q7.3 (D)
unnamed: D8.2 (A), K8.A2, Q8.3 (D)
unnamed: D9.2 (A), K9.A2, Q9.3 (D)
unnamed: D10.2 (A), K10.A2, Q10.3 (D)
unnamed: D11.2 (A), K11.A2, Q11.3 (D)
unnamed: D12.2 (A), K12.A2, Q12.3 (D)
unnamed: D13.2 (A), K13.A2, Q13.3 (D)
unnamed: D14.2 (A), K14.A2, Q14.3 (D)
unnamed: D15.2 (A), K15.A2, Q15.3 (D)
unnamed: D16.2 (A), K16.A2, Q16.3 (D)
unnamed: J1.2, U1.13 (SDA)
unnamed: J1.3, U1.12 (SCK)
unnamed: J2.1, K1.14
unnamed: J2.2, K1.12
unnamed: J2.3, K1.11
unnamed: J3.1, K2.14
unnamed: J3.2, K2.12
unnamed: J3.3, K2.11
unnamed: J4.1, K3.14
unnamed: J4.2, K3.12
unnamed: J4.3, K3.11
unnamed: J5.1, K4.14
unnamed: J5.2, K4.12
unnamed: J5.3, K4.11
unnamed: J6.1, K5.14
unnamed: J6.2, K5.12
unnamed: J6.3, K5.11
unnamed: J7.1, K6.14
unnamed: J7.2, K6.12
unnamed: J7.3, K6.11
unnamed: J8.1, K7.14
unnamed: J8.2, K7.12
unnamed: J8.3, K7.11
unnamed: J9.1, K8.14
unnamed: J9.2, K8.12
unnamed: J9.3, K8.11
unnamed: J10.1, K9.14
unnamed: J10.2, K9.12
unnamed: J10.3, K9.11
unnamed: J11.1, K10.14
unnamed: J11.2, K10.12
unnamed: J11.3, K10.11
unnamed: J12.1, K11.14
unnamed: J12.2, K11.12
unnamed: J12.3, K11.11
unnamed: J13.1, K12.14
unnamed: J13.2, K12.12
unnamed: J13.3, K12.11
unnamed: J14.1, K13.14
unnamed: J14.2, K13.12
unnamed: J14.3, K13.11
unnamed: J15.1, K14.14
unnamed: J15.2, K14.12
unnamed: J15.3, K14.11
unnamed: J16.1, K15.14
unnamed: J16.2, K15.12
unnamed: J16.3, K15.11
unnamed: J17.1, K16.14
unnamed: J17.2, K16.12
unnamed: J17.3, K16.11
unnamed: R9.1, U1.21 (GPA0)
unnamed: R10.1, U1.22 (GPA1)
unnamed: R11.1, U1.23 (GPA2)
unnamed: R12.1, U1.24 (GPA3)
unnamed: R13.1, U1.25 (GPA4)
unnamed: R14.1, U1.26 (GPA5)
unnamed: R15.1, U1.27 (GPA6)
unnamed: R16.1, U1.28 (GPA7)
unnamed: R1.1, U1.1 (GPB0)
unnamed: R2.1, U1.2 (GPB1)
unnamed: R3.1, U1.3 (GPB2)
unnamed: R4.1, U1.4 (GPB3)
unnamed: R5.1, U1.5 (GPB4)
unnamed: R6.1, U1.6 (GPB5)
unnamed: R7.1, U1.7 (GPB6)
unnamed: R8.1, U1.8 (GPB7)
VCC: D1.1 (K), D2.1 (K), D3.1 (K), D4.1 (K), D5.1 (K), D6.1 (K), D7.1 (K), D8.1 (K), D9.1 (K), D10.1 (K), D11.1 (K), D12.1 (K), D13.1 (K), D14.1 (K), D15.1 (K), D16.1 (K), J1.1, JP1.1 (A), JP2.1 (A), JP3.1 (A), K1.A1, K2.A1, K3.A1, K4.A1, K5.A1, K6.A1, K7.A1, K8.A1, K9.A1, K10.A1, K11.A1, K12.A1, K13.A1, K14.A1, K15.A1, K16.A1, U1.9 (VDD), U1.18 (~RESET)

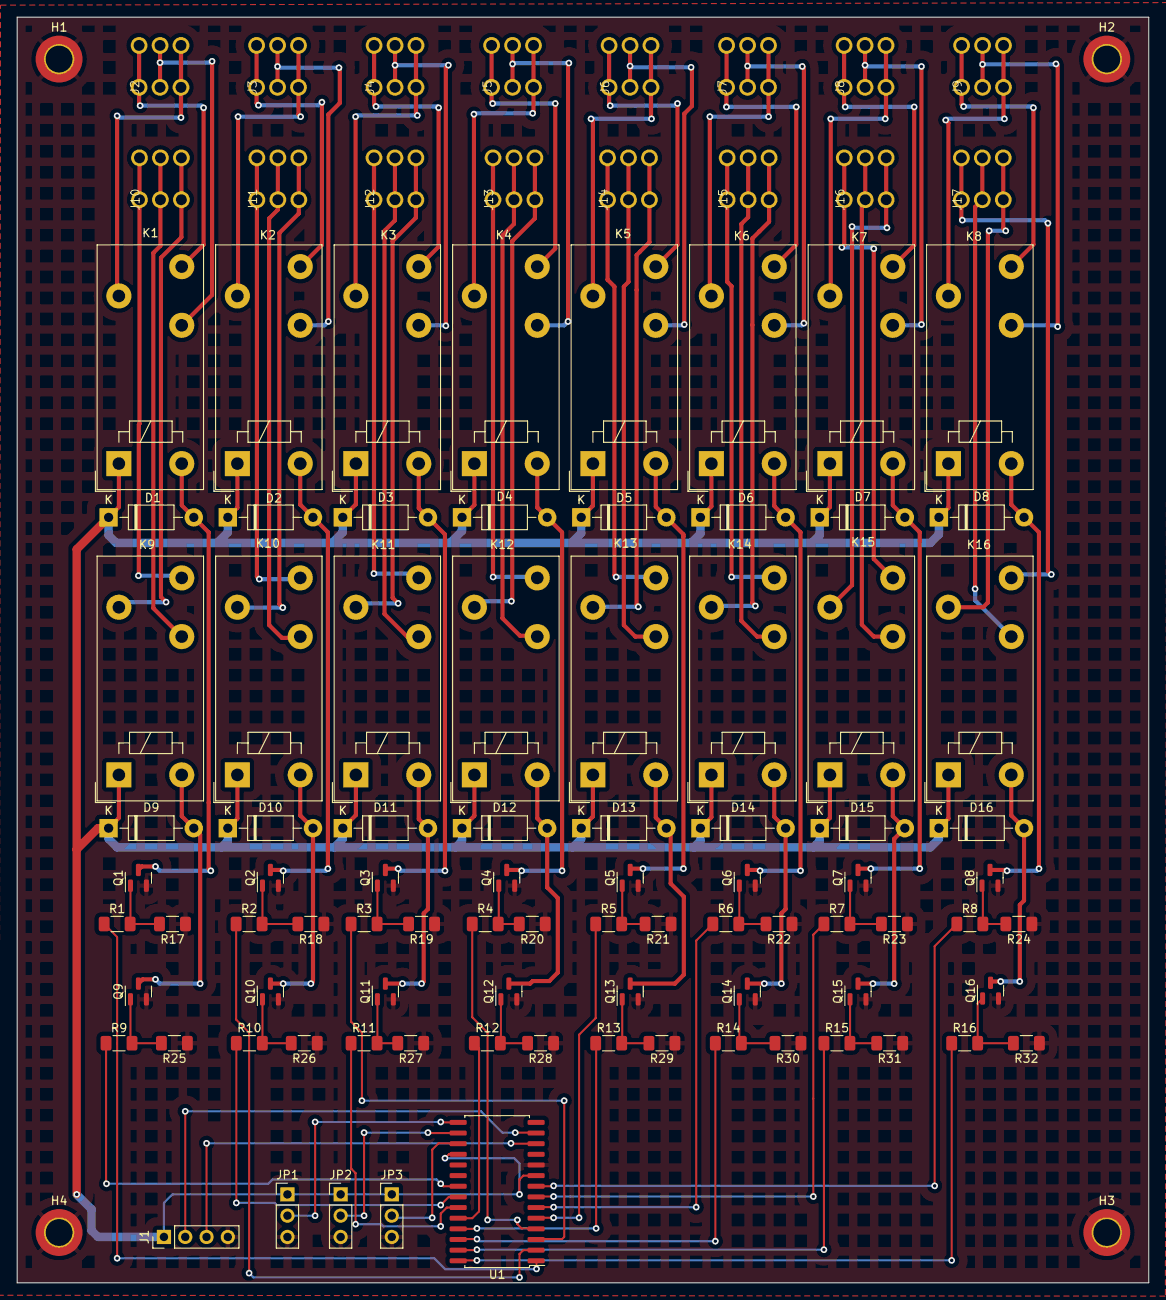
[picture p19: board mqtt_out_box_16o.kicad_pcb from above]

Board: 2 copper layers, 135.0 x 151.0 mm, 105 parts (0 on the bottom side), 103 nets.
