tekki-tom/mqtt_io/mqtt_io/in_out/mqtt_io_inOut_8i_8o_tht/mqtt_io_inOut_8i_8o_tht.kicad_pcb

## KiCad design mqtt_io/in_out/mqtt_io_inOut_8i_8o_tht/mqtt_io_inOut_8i_8o_tht.kicad_pcb (2023-04-23)

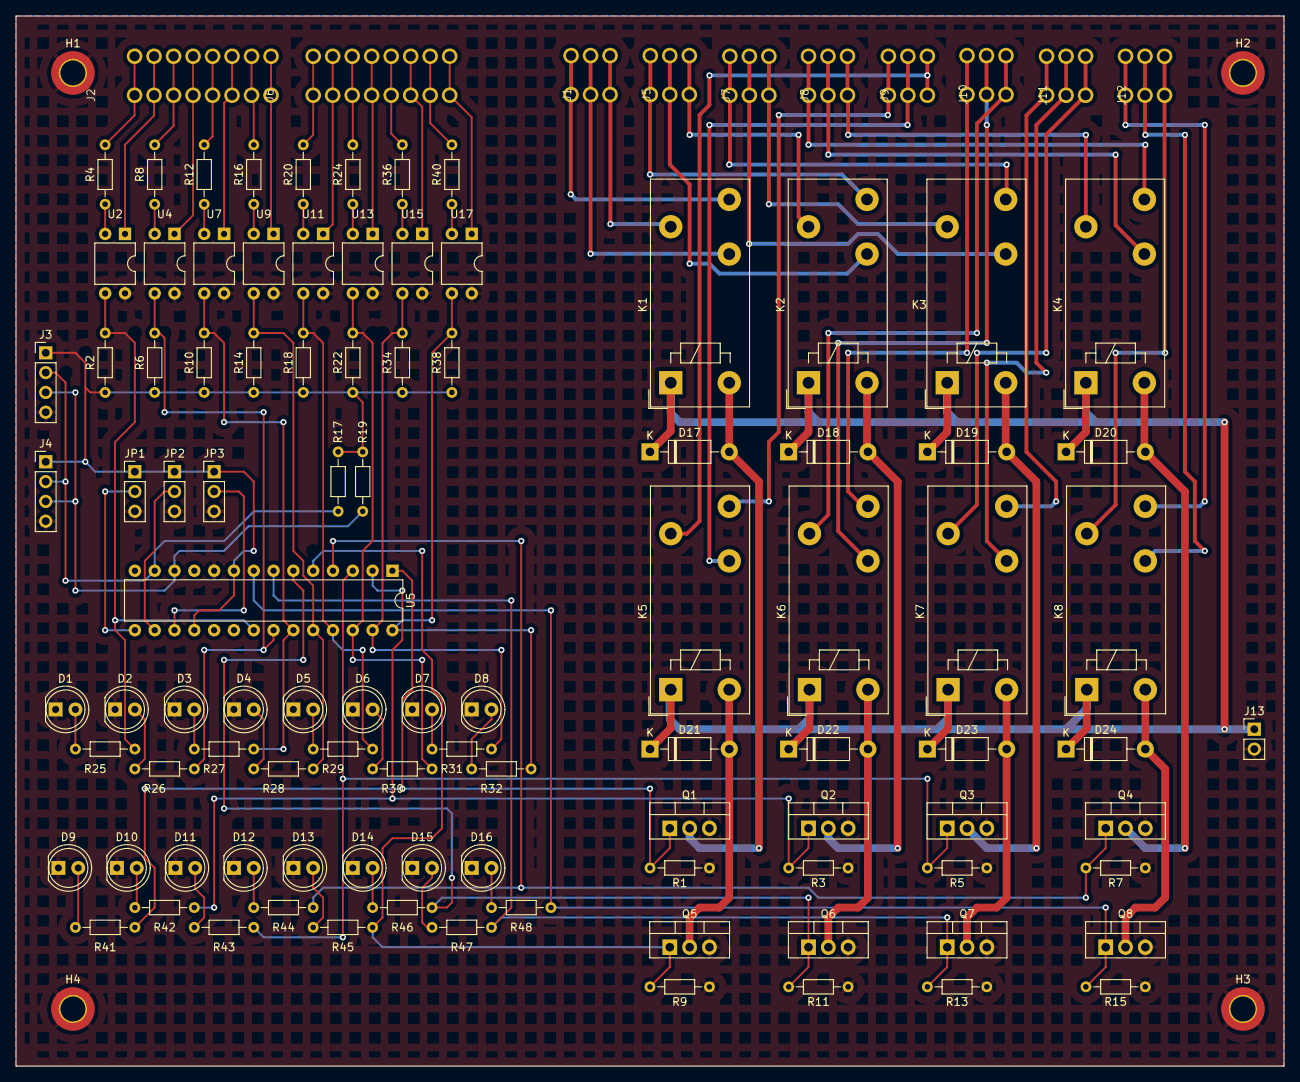
[picture p20: board mqtt_io_inOut_8i_8o_tht.kicad_pcb from above]

Board: 2 copper layers, 162.6 x 134.6 mm, 111 parts (0 on the bottom side), 96 nets.

Parts:
D1, D2, D3, D4, D5, D6, D7, D8, D9, D10, D11, D12, D13, D14, D15, D16: LED; LED_D5.0mm
D17, D18, D19, D20, D21, D22, D23, D24: 1N4001; D_DO-41_SOD81_P10.16mm_Horizontal
H1, H2, H3, H4: MountingHole_Pad; MountingHole_3.2mm_M3_DIN965_Pad_TopBottom
J1, J5, J7, J8, J9, J10, J11, J12: AST_041-3
J2, J6: AST041-08
J3, J4: Conn_01x04_Pin; PinHeader_1x04_P2.54mm_Vertical
J13: Conn_01x02; PinHeader_1x02_P2.54mm_Vertical
JP1, JP2, JP3: Jumper_3_Open; PinHeader_1x03_P2.54mm_Vertical
K1, K2, K3, K4, K5, K6, K7, K8: FINDER-40.31; Relay_SPDT_Finder_40.31
Q1, Q2, Q3, Q4, Q5, Q6, Q7, Q8: IRFZ24N; TO-220-3_Vertical
R1, R3, R5, R7, R9, R11, R13, R15: 100kR; R_Axial_DIN0204_L3.6mm_D1.6mm_P7.62mm_Horizontal
R2, R6, R10, R14, R18, R22, R34, R38: 10kR; R_Axial_DIN0204_L3.6mm_D1.6mm_P7.62mm_Horizontal
R4, R8, R12, R16, R20, R24, R36, R40: 1200R; R_Axial_DIN0204_L3.6mm_D1.6mm_P7.62mm_Horizontal
R17, R19: 4k7; R_Axial_DIN0204_L3.6mm_D1.6mm_P7.62mm_Horizontal
R25, R26, R27, R28, R29, R30, R31, R32, R41, R42, R43, R44, R45, R46, R47, R48: 330R; R_Axial_DIN0204_L3.6mm_D1.6mm_P7.62mm_Horizontal
U2, U4, U7, U9, U11, U13, U15, U17: LTV-817; DIP-4_W7.62mm
U5: MCP23017_SP; DIP-28_W7.62mm

Connections:
/AD0: JP1.2 (C), U5.15 (A0)
/AD1: JP2.2 (C), U5.16 (A1)
/AD2: JP3.2 (C), U5.17 (A2)
/a0: R2.2, R25.2, U2.3, U5.21 (GPA0)
/a1: R6.2, R26.2, U4.3, U5.22 (GPA1)
/a2: R10.2, R27.2, U5.23 (GPA2), U7.3
/a3: R14.2, R28.2, U5.24 (GPA3), U9.3
/a4: R18.2, R29.2, U5.25 (GPA4), U11.3
/a5: R22.2, R30.2, U5.26 (GPA5), U13.3
/a6: R31.2, R34.2, U5.27 (GPA6), U15.3
/a7: R32.2, R38.2, U5.28 (GPA7), U17.3
/b0: Q1.1 (G), R1.2, R41.2, U5.1 (GPB0)
/b1: Q2.1 (G), R3.2, R42.2, U5.2 (GPB1)
/b2: Q3.1 (G), R5.2, R43.2, U5.3 (GPB2)
/b3: Q4.1 (G), R7.2, R44.2, U5.4 (GPB3)
/b4: Q5.1 (G), R9.2, R45.2, U5.5 (GPB4)
/b5: Q6.1 (G), R11.2, R46.2, U5.6 (GPB5)
/b6: Q7.1 (G), R13.2, R47.2, U5.7 (GPB6)
/b7: Q8.1 (G), R15.2, R48.2, U5.8 (GPB7)
GND: D1.1 (K), D2.1 (K), D3.1 (K), D4.1 (K), D5.1 (K), D6.1 (K), D7.1 (K), D8.1 (K), D9.1 (K), D10.1 (K), D11.1 (K), D12.1 (K), D13.1 (K), D14.1 (K), D15.1 (K), D16.1 (K), H1.1, H2.1, H3.1, H4.1, J3.4, J4.4, J13.2, JP1.3 (B), JP2.3 (B), JP3.3 (B), Q1.3 (S), Q2.3 (S), Q3.3 (S), Q4.3 (S), Q5.3 (S), Q6.3 (S), Q7.3 (S), Q8.3 (S), R1.1, R3.1, R5.1, R7.1, R9.1, R11.1, R13.1, R15.1, U2.4, U4.4, U5.10 (VSS), U7.4, U9.4, U11.4, U13.4, U15.4, U17.4
unnamed: D1.2 (A), R25.1
unnamed: D2.2 (A), R26.1
unnamed: D3.2 (A), R27.1
unnamed: D4.2 (A), R28.1
unnamed: D5.2 (A), R29.1
unnamed: D6.2 (A), R30.1
unnamed: D7.2 (A), R31.1
unnamed: D8.2 (A), R32.1
unnamed: D9.2 (A), R41.1
unnamed: D10.2 (A), R42.1
unnamed: D11.2 (A), R43.1
unnamed: D12.2 (A), R44.1
unnamed: D13.2 (A), R45.1
unnamed: D14.2 (A), R46.1
unnamed: D15.2 (A), R47.1
unnamed: D16.2 (A), R48.1
unnamed: D17.2 (A), K1.A2, Q1.2 (D)
unnamed: D18.2 (A), K2.A2, Q2.2 (D)
unnamed: D19.2 (A), K3.A2, Q3.2 (D)
unnamed: D20.2 (A), K4.A2, Q4.2 (D)
unnamed: D21.2 (A), K5.A2, Q5.2 (D)
unnamed: D22.2 (A), K6.A2, Q6.2 (D)
unnamed: D23.2 (A), K7.A2, Q7.2 (D)
unnamed: D24.2 (A), K8.A2, Q8.2 (D)
unnamed: J1.1, K1.14
unnamed: J1.2, K1.12
unnamed: J1.3, K1.11
unnamed: J2.1 (io), R4.2
unnamed: J2.2 (io), U2.1
unnamed: J2.3 (io), R8.2
unnamed: J2.4 (io), U4.1
unnamed: J2.5 (io), R12.2
unnamed: J2.6 (io), U7.1
unnamed: J2.7 (io), R16.2
unnamed: J2.8 (io), U9.1
unnamed: J3.2, J4.2, R17.1, U5.13 (SDA)
unnamed: J3.3, J4.3, R19.1, U5.12 (SCK)
unnamed: J5.1, K2.14
unnamed: J5.2, K2.12
unnamed: J5.3, K2.11
unnamed: J6.1 (io), R20.2
unnamed: J6.2 (io), U11.1
unnamed: J6.3 (io), R24.2
unnamed: J6.4 (io), U13.1
unnamed: J6.5 (io), R36.2
unnamed: J6.6 (io), U15.1
unnamed: J6.7 (io), R40.2
unnamed: J6.8 (io), U17.1
unnamed: J7.1, K3.14
unnamed: J7.2, K3.12
unnamed: J7.3, K3.11
unnamed: J8.1, K4.14
unnamed: J8.2, K4.12
unnamed: J8.3, K4.11
unnamed: J9.1, K5.14
unnamed: J9.2, K5.12
unnamed: J9.3, K5.11
unnamed: J10.1, K6.14
unnamed: J10.2, K6.12
unnamed: J10.3, K6.11
unnamed: J11.1, K7.14
unnamed: J11.2, K7.12
unnamed: J11.3, K7.11
unnamed: J12.1, K8.14
unnamed: J12.2, K8.12
unnamed: J12.3, K8.11
unnamed: R4.1, U2.2
unnamed: R8.1, U4.2
unnamed: R12.1, U7.2
unnamed: R16.1, U9.2
unnamed: R20.1, U11.2
unnamed: R24.1, U13.2
unnamed: R36.1, U15.2
unnamed: R40.1, U17.2
VCC: D17.1 (K), D18.1 (K), D19.1 (K), D20.1 (K), D21.1 (K), D22.1 (K), D23.1 (K), D24.1 (K), J13.1, K1.A1, K2.A1, K3.A1, K4.A1, K5.A1, K6.A1, K7.A1, K8.A1
VDD: J3.1, J4.1, JP1.1 (A), JP2.1 (A), JP3.1 (A), R2.1, R6.1, R10.1, R14.1, R17.2, R18.1, R19.2, R22.1, R34.1, R38.1, U5.9 (VDD), U5.18 (~RESET)
