tekki-tom/mqtt_io/mqtt_io/out/mqtt_out_box_16o_tht/rev1/mqtt_out_box_16o_tht_rev1.kicad_pcb

## KiCad design mqtt_io/out/mqtt_out_box_16o_tht/rev1/mqtt_out_box_16o_tht_rev1.kicad_pcb (2023-04-23, an earlier design)

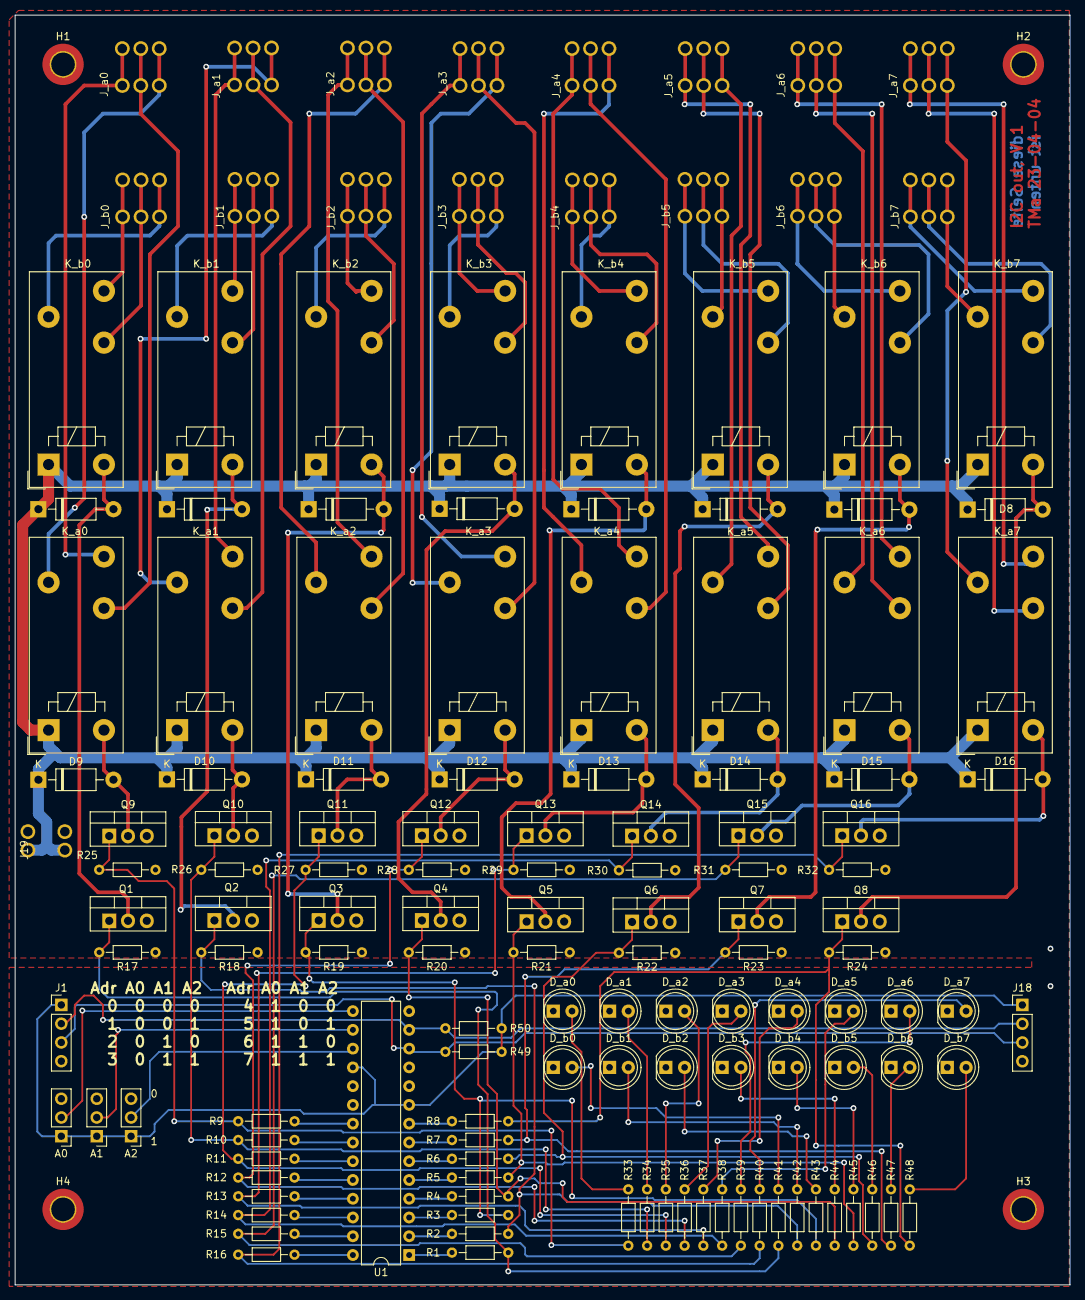
[picture p21: board mqtt_out_box_16o_tht_rev1.kicad_pcb from above]

Board: 2 copper layers, 142.8 x 171.9 mm, 141 parts (0 on the bottom side), 120 nets.

Parts:
A0, A1, A2: Jumper_3_Open; PinHeader_1x03_P2.54mm_Vertical
D1, D2, D3, D4, D5, D6, D7, D8, D9, D10, D11, D12, D13, D14, D15, D16: 1N4001; D_DO-41_SOD81_P10.16mm_Horizontal
D_a0, D_a1, D_a2, D_a3, D_a4, D_a5, D_a6, D_a7: LED; LED_D5.0mm
D_b0, D_b1, D_b2, D_b3, D_b4, D_b5, D_b6, D_b7: LED; LED_D5.0mm
H1, H2, H3, H4: MountingHole_Pad; MountingHole_3.2mm_M3_DIN965_Pad_TopBottom
J1, J18: Conn_01x04_Pin; PinHeader_1x04_P2.54mm_Vertical
J19: AST_041-2
J_a0, J_a1, J_a2, J_a3, J_a4, J_a5, J_a6, J_a7: AST_041-3
J_b0, J_b1, J_b2, J_b3, J_b4, J_b5, J_b6, J_b7: AST_041-3
K_a0, K_a1, K_a2, K_a3, K_a4, K_a5, K_a6, K_a7: FINDER-40.31; Relay_SPDT_Finder_40.31
K_b0, K_b1, K_b2, K_b3, K_b4, K_b5, K_b6, K_b7: FINDER-40.31; Relay_SPDT_Finder_40.31
Q1, Q2, Q3, Q4, Q5, Q6, Q7, Q8, Q9, Q10, Q11, Q12, Q13, Q14, Q15, Q16: IRFZ24N; TO-220-3_Vertical
R1, R2, R3, R4, R5, R6, R7, R8, R9, R10, R11, R12, R13, R14, R15, R16: 100R; R_Axial_DIN0204_L3.6mm_D1.6mm_P7.62mm_Horizontal
R17, R18, R19, R20, R21, R22, R23, R24, R25, R26, R27, R28, R29, R30, R31, R32: 100kR; R_Axial_DIN0204_L3.6mm_D1.6mm_P7.62mm_Horizontal
R33, R34, R35, R36, R37, R38, R39, R40, R41, R42, R43, R44, R45, R46, R47, R48: 330R; R_Axial_DIN0204_L3.6mm_D1.6mm_P7.62mm_Horizontal
R49, R50: 4k7; R_Axial_DIN0204_L3.6mm_D1.6mm_P7.62mm_Horizontal
U1: MCP23017_SP; DIP-28_W7.62mm

Connections:
/AD0: A0.2 (C), U1.15 (A0)
/AD1: A1.2 (C), U1.16 (A1)
/AD2: A2.2 (C), U1.17 (A2)
/a0: Q9.1 (G), R9.2, R25.2, R33.2
/a1: Q10.1 (G), R10.2, R26.2, R34.2
/a2: Q11.1 (G), R11.2, R27.2, R35.2
/a3: Q12.1 (G), R12.2, R28.2, R36.2
/a4: Q13.1 (G), R13.2, R29.2, R37.2
/a5: Q14.1 (G), R14.2, R30.2, R38.2
/a6: Q15.1 (G), R15.2, R31.2, R39.2
/a7: Q16.1 (G), R16.2, R32.2, R40.2
/b0: Q1.1 (G), R1.2, R17.2, R41.2
/b1: Q2.1 (G), R2.2, R18.2, R42.2
/b2: Q3.1 (G), R3.2, R19.2, R43.2
/b3: Q4.1 (G), R4.2, R20.2, R44.2
/b4: Q5.1 (G), R5.2, R21.2, R45.2
/b5: Q6.1 (G), R6.2, R22.2, R46.2
/b6: Q7.1 (G), R7.2, R23.2, R47.2
/b7: Q8.1 (G), R8.2, R24.2, R48.2
GND: A0.3 (B), A1.3 (B), A2.3 (B), D_a0.1 (K), D_a1.1 (K), D_a2.1 (K), D_a3.1 (K), D_a4.1 (K), D_a5.1 (K), D_a6.1 (K), D_a7.1 (K), D_b0.1 (K), D_b1.1 (K), D_b2.1 (K), D_b3.1 (K), D_b4.1 (K), D_b5.1 (K), D_b6.1 (K), D_b7.1 (K), H1.1, H2.1, H3.1, H4.1, J1.4, J18.4, J19.2, Q1.3 (S), Q2.3 (S), Q3.3 (S), Q4.3 (S), Q5.3 (S), Q6.3 (S), Q7.3 (S), Q8.3 (S), Q9.3 (S), Q10.3 (S), Q11.3 (S), Q12.3 (S), Q13.3 (S), Q14.3 (S), Q15.3 (S), Q16.3 (S), R17.1, R18.1, R19.1, R20.1, R21.1, R22.1, R23.1, R24.1, R25.1, R26.1, R27.1, R28.1, R29.1, R30.1, R31.1, R32.1, U1.10 (VSS)
unnamed: D1.2 (A), K_b0.A2, Q1.2 (D)
unnamed: D2.2 (A), K_b1.A2, Q2.2 (D)
unnamed: D3.2 (A), K_b2.A2, Q3.2 (D)
unnamed: D4.2 (A), K_b3.A2, Q4.2 (D)
unnamed: D5.2 (A), K_b4.A2, Q5.2 (D)
unnamed: D6.2 (A), K_b5.A2, Q6.2 (D)
unnamed: D7.2 (A), K_b6.A2, Q7.2 (D)
unnamed: D8.2 (A), K_b7.A2, Q8.2 (D)
unnamed: D9.2 (A), K_a0.A2, Q9.2 (D)
unnamed: D10.2 (A), K_a1.A2, Q10.2 (D)
unnamed: D11.2 (A), K_a2.A2, Q11.2 (D)
unnamed: D12.2 (A), K_a3.A2, Q12.2 (D)
unnamed: D13.2 (A), K_a4.A2, Q13.2 (D)
unnamed: D14.2 (A), K_a5.A2, Q14.2 (D)
unnamed: D15.2 (A), K_a6.A2, Q15.2 (D)
unnamed: D16.2 (A), K_a7.A2, Q16.2 (D)
unnamed: D_a0.2 (A), R33.1
unnamed: D_a1.2 (A), R34.1
unnamed: D_a2.2 (A), R35.1
unnamed: D_a3.2 (A), R36.1
unnamed: D_a4.2 (A), R37.1
unnamed: D_a5.2 (A), R38.1
unnamed: D_a6.2 (A), R39.1
unnamed: D_a7.2 (A), R40.1
unnamed: D_b0.2 (A), R41.1
unnamed: D_b1.2 (A), R42.1
unnamed: D_b2.2 (A), R43.1
unnamed: D_b3.2 (A), R44.1
unnamed: D_b4.2 (A), R45.1
unnamed: D_b5.2 (A), R46.1
unnamed: D_b6.2 (A), R47.1
unnamed: D_b7.2 (A), R48.1
unnamed: J1.2, J18.2, R50.1, U1.13 (SDA)
unnamed: J1.3, J18.3, R49.1, U1.12 (SCK)
unnamed: J_a0.1, K_a0.14
unnamed: J_a0.2, K_a0.12
unnamed: J_a0.3, K_a0.11
unnamed: J_a1.1, K_a1.14
unnamed: J_a1.2, K_a1.12
unnamed: J_a1.3, K_a1.11
unnamed: J_a2.1, K_a2.14
unnamed: J_a2.2, K_a2.12
unnamed: J_a2.3, K_a2.11
unnamed: J_a3.1, K_a3.14
unnamed: J_a3.2, K_a3.12
unnamed: J_a3.3, K_a3.11
unnamed: J_a4.1, K_a4.14
unnamed: J_a4.2, K_a4.12
unnamed: J_a4.3, K_a4.11
unnamed: J_a5.1, K_a5.14
unnamed: J_a5.2, K_a5.12
unnamed: J_a5.3, K_a5.11
unnamed: J_a6.1, K_a6.14
unnamed: J_a6.2, K_a6.12
unnamed: J_a6.3, K_a6.11
unnamed: J_a7.1, K_a7.14
unnamed: J_a7.2, K_a7.12
unnamed: J_a7.3, K_a7.11
unnamed: J_b0.1, K_b0.14
unnamed: J_b0.2, K_b0.12
unnamed: J_b0.3, K_b0.11
unnamed: J_b1.1, K_b1.14
unnamed: J_b1.2, K_b1.12
unnamed: J_b1.3, K_b1.11
unnamed: J_b2.1, K_b2.14
unnamed: J_b2.2, K_b2.12
unnamed: J_b2.3, K_b2.11
unnamed: J_b3.1, K_b3.14
unnamed: J_b3.2, K_b3.12
unnamed: J_b3.3, K_b3.11
unnamed: J_b4.1, K_b4.14
unnamed: J_b4.2, K_b4.12
unnamed: J_b4.3, K_b4.11
unnamed: J_b5.1, K_b5.14
unnamed: J_b5.2, K_b5.12
unnamed: J_b5.3, K_b5.11
unnamed: J_b6.1, K_b6.14
unnamed: J_b6.2, K_b6.12
unnamed: J_b6.3, K_b6.11
unnamed: J_b7.1, K_b7.14
unnamed: J_b7.2, K_b7.12
unnamed: J_b7.3, K_b7.11
unnamed: R9.1, U1.21 (GPA0)
unnamed: R10.1, U1.22 (GPA1)
unnamed: R11.1, U1.23 (GPA2)
unnamed: R12.1, U1.24 (GPA3)
unnamed: R13.1, U1.25 (GPA4)
unnamed: R14.1, U1.26 (GPA5)
unnamed: R15.1, U1.27 (GPA6)
unnamed: R16.1, U1.28 (GPA7)
unnamed: R1.1, U1.1 (GPB0)
unnamed: R2.1, U1.2 (GPB1)
unnamed: R3.1, U1.3 (GPB2)
unnamed: R4.1, U1.4 (GPB3)
unnamed: R5.1, U1.5 (GPB4)
unnamed: R6.1, U1.6 (GPB5)
unnamed: R7.1, U1.7 (GPB6)
unnamed: R8.1, U1.8 (GPB7)
VCC: D1.1 (K), D2.1 (K), D3.1 (K), D4.1 (K), D5.1 (K), D6.1 (K), D7.1 (K), D8.1 (K), D9.1 (K), D10.1 (K), D11.1 (K), D12.1 (K), D13.1 (K), D14.1 (K), D15.1 (K), D16.1 (K), J19.1, K_a0.A1, K_a1.A1, K_a2.A1, K_a3.A1, K_a4.A1, K_a5.A1, K_a6.A1, K_a7.A1, K_b0.A1, K_b1.A1, K_b2.A1, K_b3.A1, K_b4.A1, K_b5.A1, K_b6.A1, K_b7.A1
VDD: A0.1 (A), A1.1 (A), A2.1 (A), J1.1, J18.1, R49.2, R50.2, U1.9 (VDD), U1.18 (~RESET)
