tekki-tom/mqtt_io/mqtt_io/in_out/mqtt_io_inOut_8i_8o_smd_optp/mqtt_io_inOut_8i_8o_smd_optp.kicad_pcb

## KiCad design mqtt_io/in_out/mqtt_io_inOut_8i_8o_smd_optp/mqtt_io_inOut_8i_8o_smd_optp.kicad_pcb (2023-04-23)

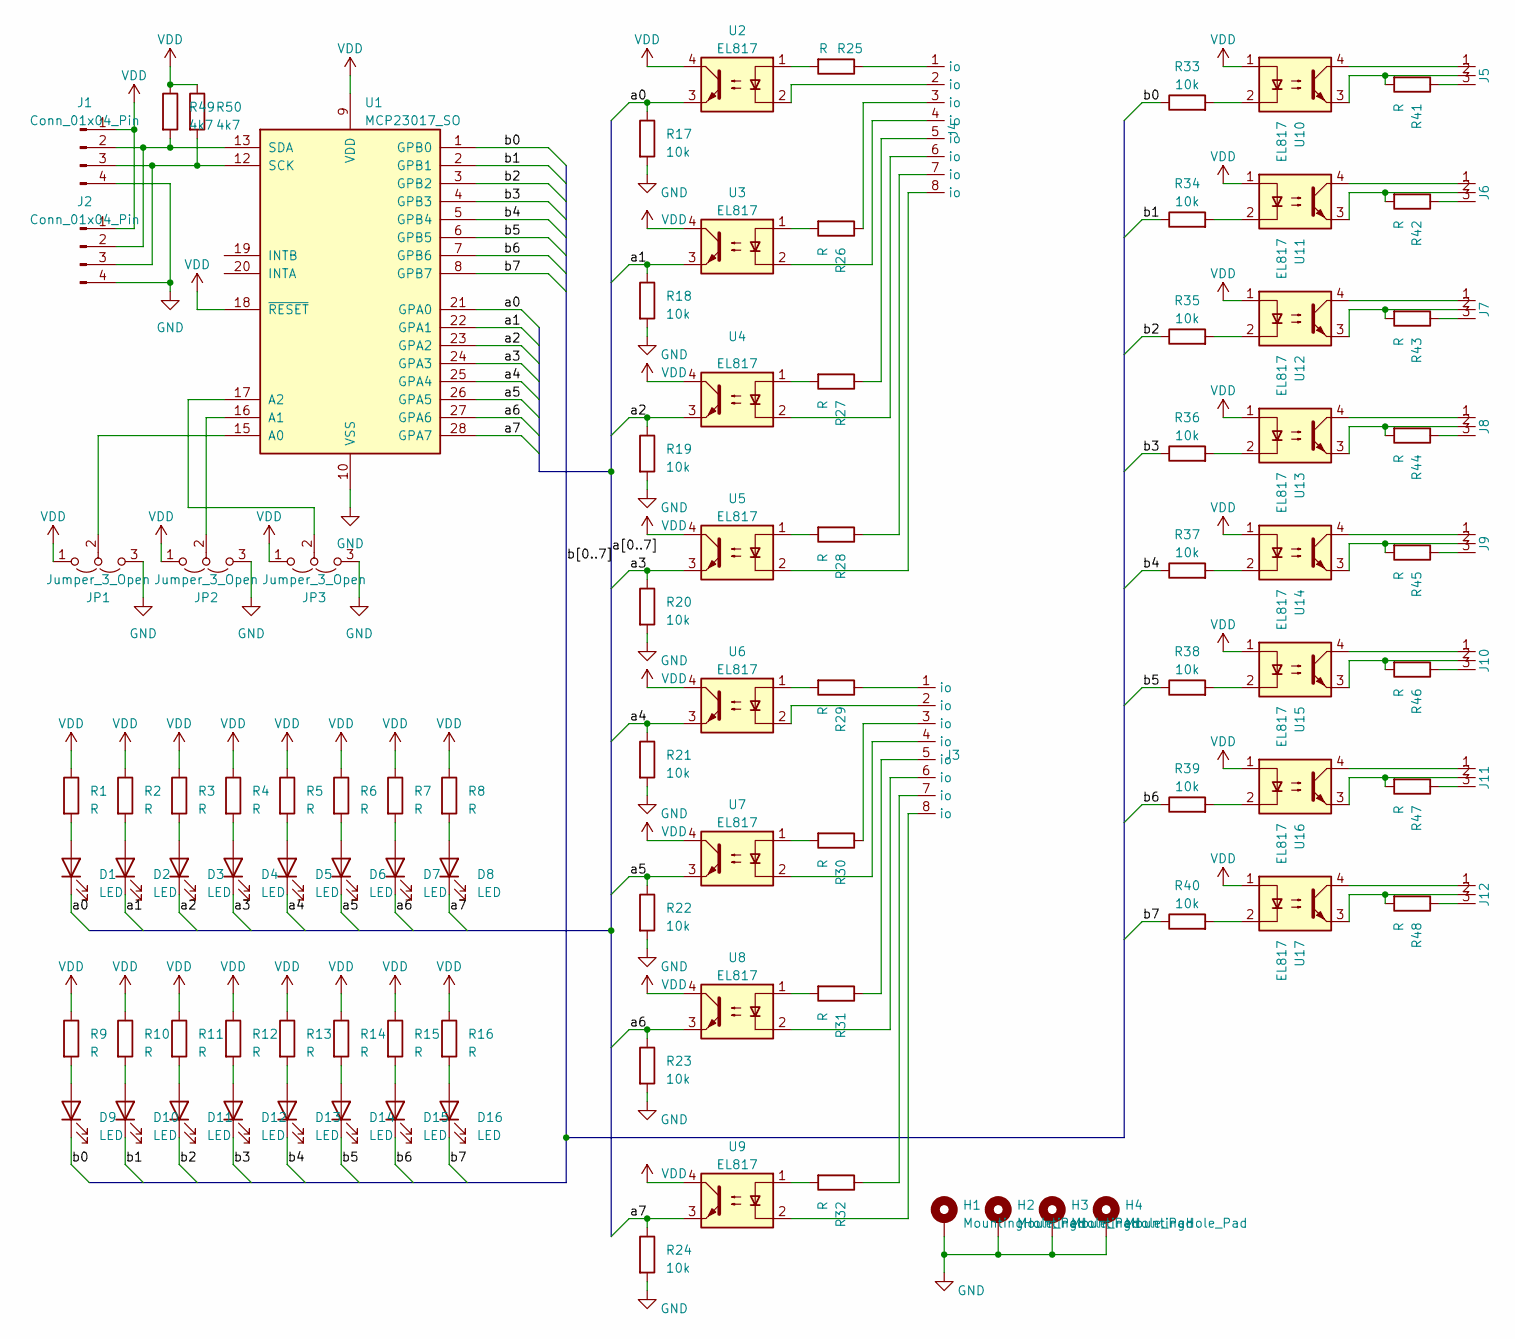
[picture p22: schematic mqtt_io_inOut_8i_8o_smd_optp.kicad_sch]

Parts:
D1, D2, D3, D4, D5, D6, D7, D8, D9, D10, D11, D12, D13, D14, D15, D16: LED; LED_1206_3216Metric_Pad1.42x1.75mm_HandSolder
H1, H2, H3, H4: MountingHole_Pad; MountingHole_3.2mm_M3_DIN965_Pad_TopBottom
J1, J2: Conn_01x04_Pin; PinHeader_1x04_P2.54mm_Vertical
J3, J4: AST041-08
J5, J6, J7, J8, J9, J10, J11, J12: AST_041-3
JP1, JP2, JP3: Jumper_3_Open; PinHeader_1x03_P2.54mm_Vertical
R1, R2, R3, R4, R5, R6, R7, R8, R9, R10, R11, R12, R13, R14, R15, R16, R25, R26, R27, R28, R29, R30, R31, R32, R41, R42, R43, R44, R45, R46, R47, R48: R; R_1206_3216Metric_Pad1.30x1.75mm_HandSolder
R17, R18, R19, R20, R21, R22, R23, R24, R33, R34, R35, R36, R37, R38, R39, R40: 10k; R_1206_3216Metric_Pad1.30x1.75mm_HandSolder
R49, R50: 4k7; R_1206_3216Metric_Pad1.30x1.75mm_HandSolder
U1: MCP23017_SO; SOIC-28W_7.5x17.9mm_P1.27mm
U2, U3, U4, U5, U6, U7, U8, U9, U10, U11, U12, U13, U14, U15, U16, U17: EL817; DIP-4_W7.62mm_SMDSocket_SmallPads

Connections:
/a0: D1.1 (K), R17.1, U1.21 (GPA0), U2.3
/a1: D2.1 (K), R18.1, U1.22 (GPA1), U3.3
/a2: D3.1 (K), R19.1, U1.23 (GPA2), U4.3
/a3: D4.1 (K), R20.1, U1.24 (GPA3), U5.3
/a4: D5.1 (K), R21.1, U1.25 (GPA4), U6.3
/a5: D6.1 (K), R22.1, U1.26 (GPA5), U7.3
/a6: D7.1 (K), R23.1, U1.27 (GPA6), U8.3
/a7: D8.1 (K), R24.1, U1.28 (GPA7), U9.3
/b0: D9.1 (K), R33.1, U1.1 (GPB0)
/b1: D10.1 (K), R34.1, U1.2 (GPB1)
/b2: D11.1 (K), R35.1, U1.3 (GPB2)
/b3: D12.1 (K), R36.1, U1.4 (GPB3)
/b4: D13.1 (K), R37.1, U1.5 (GPB4)
/b5: D14.1 (K), R38.1, U1.6 (GPB5)
/b6: D15.1 (K), R39.1, U1.7 (GPB6)
/b7: D16.1 (K), R40.1, U1.8 (GPB7)
GND: H1.1, H2.1, H3.1, H4.1, J1.4, J2.4, JP1.3 (B), JP2.3 (B), JP3.3 (B), R17.2, R18.2, R19.2, R20.2, R21.2, R22.2, R23.2, R24.2, U1.10 (VSS)
unnamed: D1.2 (A), R1.2
unnamed: D2.2 (A), R2.2
unnamed: D3.2 (A), R3.2
unnamed: D4.2 (A), R4.2
unnamed: D5.2 (A), R5.2
unnamed: D6.2 (A), R6.2
unnamed: D7.2 (A), R7.2
unnamed: D8.2 (A), R8.2
unnamed: D9.2 (A), R9.2
unnamed: D10.2 (A), R10.2
unnamed: D11.2 (A), R11.2
unnamed: D12.2 (A), R12.2
unnamed: D13.2 (A), R13.2
unnamed: D14.2 (A), R14.2
unnamed: D15.2 (A), R15.2
unnamed: D16.2 (A), R16.2
unnamed: J1.2, J2.2, R49.2, U1.13 (SDA)
unnamed: J1.3, J2.3, R50.2, U1.12 (SCK)
unnamed: J3.1 (io), R29.1
unnamed: J3.2 (io), U6.2
unnamed: J3.3 (io), R30.1
unnamed: J3.4 (io), U7.2
unnamed: J3.5 (io), R31.1
unnamed: J3.6 (io), U8.2
unnamed: J3.7 (io), R32.1
unnamed: J3.8 (io), U9.2
unnamed: J4.1 (io), R25.1
unnamed: J4.2 (io), U2.2
unnamed: J4.3 (io), R26.1
unnamed: J4.4 (io), U3.2
unnamed: J4.5 (io), R27.1
unnamed: J4.6 (io), U4.2
unnamed: J4.7 (io), R28.1
unnamed: J4.8 (io), U5.2
unnamed: J5.1, U10.4
unnamed: J5.2, R41.2, U10.3
unnamed: J5.3, R41.1
unnamed: J6.1, U11.4
unnamed: J6.2, R42.2, U11.3
unnamed: J6.3, R42.1
unnamed: J7.1, U12.4
unnamed: J7.2, R43.2, U12.3
unnamed: J7.3, R43.1
unnamed: J8.1, U13.4
unnamed: J8.2, R44.2, U13.3
unnamed: J8.3, R44.1
unnamed: J9.1, U14.4
unnamed: J9.2, R45.2, U14.3
unnamed: J9.3, R45.1
unnamed: J10.1, U15.4
unnamed: J10.2, R46.2, U15.3
unnamed: J10.3, R46.1
unnamed: J11.1, U16.4
unnamed: J11.2, R47.2, U16.3
unnamed: J11.3, R47.1
unnamed: J12.1, U17.4
unnamed: J12.2, R48.2, U17.3
unnamed: J12.3, R48.1
unnamed: JP1.2 (C), U1.15 (A0)
unnamed: JP2.2 (C), U1.16 (A1)
unnamed: JP3.2 (C), U1.17 (A2)
unnamed: R25.2, U2.1
unnamed: R26.2, U3.1
unnamed: R27.2, U4.1
unnamed: R28.2, U5.1
unnamed: R29.2, U6.1
unnamed: R30.2, U7.1
unnamed: R31.2, U8.1
unnamed: R32.2, U9.1
unnamed: R33.2, U10.2
unnamed: R34.2, U11.2
unnamed: R35.2, U12.2
unnamed: R36.2, U13.2
unnamed: R37.2, U14.2
unnamed: R38.2, U15.2
unnamed: R39.2, U16.2
unnamed: R40.2, U17.2
VDD: J1.1, J2.1, JP1.1 (A), JP2.1 (A), JP3.1 (A), R1.1, R2.1, R3.1, R4.1, R5.1, R6.1, R7.1, R8.1, R9.1, R10.1, R11.1, R12.1, R13.1, R14.1, R15.1, R16.1, R49.1, R50.1, U1.9 (VDD), U1.18 (~RESET), U2.4, U3.4, U4.4, U5.4, U6.4, U7.4, U8.4, U9.4, U10.1, U11.1, U12.1, U13.1, U14.1, U15.1, U16.1, U17.1

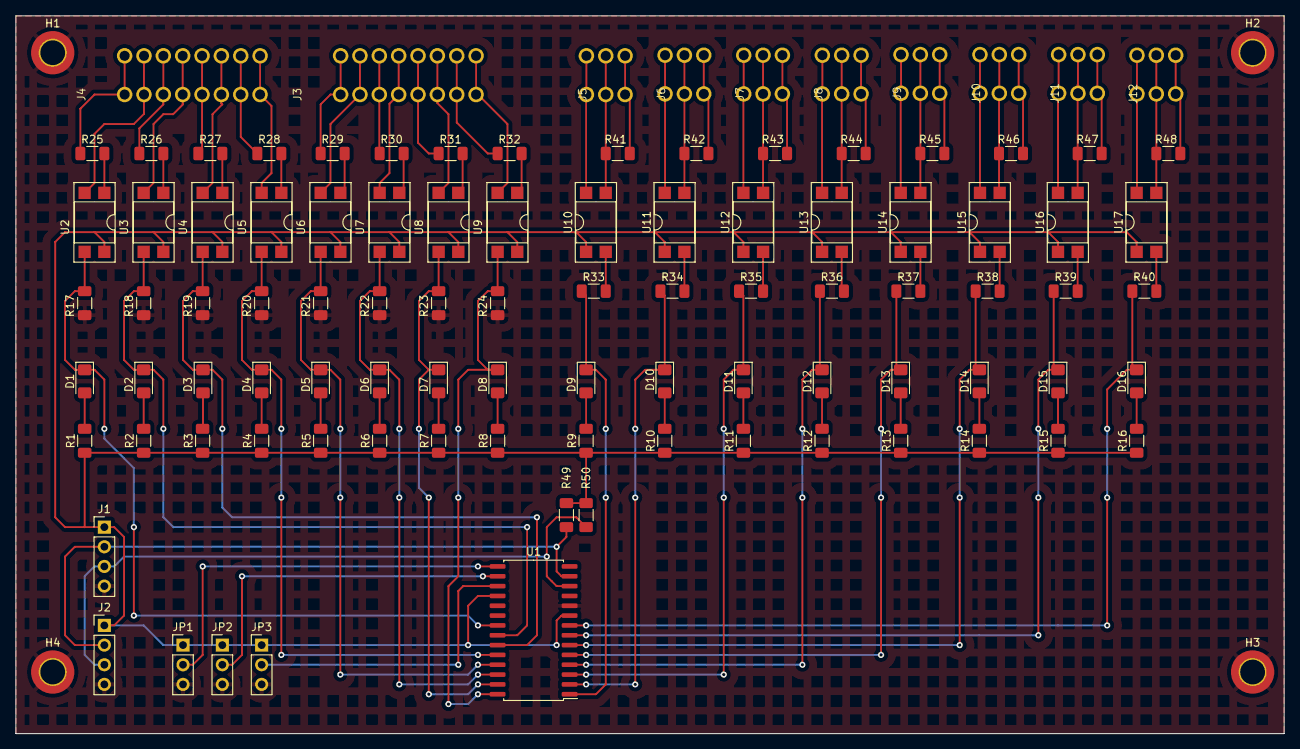
[picture p23: board mqtt_io_inOut_8i_8o_smd_optp.kicad_pcb from above]

Board: 2 copper layers, 163.8 x 92.7 mm, 102 parts (0 on the bottom side), 95 nets.
