tekki-tom/mqtt_io/mqtt_io/mqtt_basis_pi_pico/mqtt_basis_pi_pico.kicad_pcb

## KiCad design mqtt_io/mqtt_basis_pi_pico/mqtt_basis_pi_pico.kicad_pcb (2023-03-09)

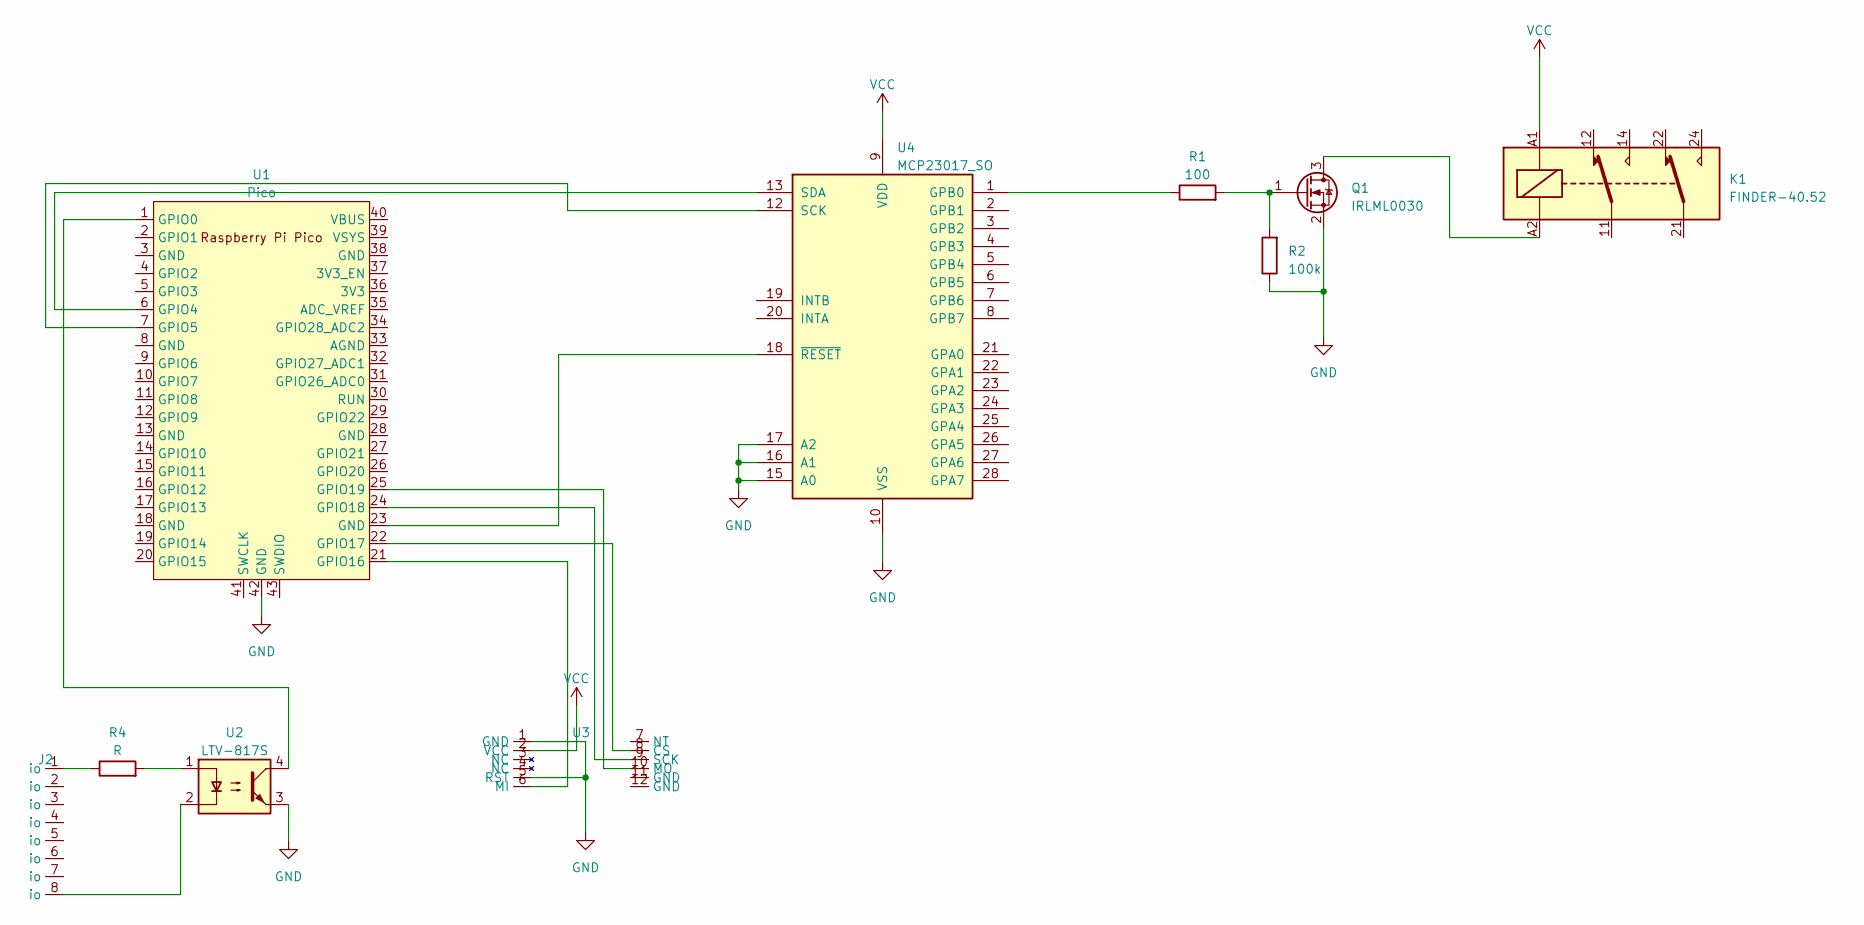
[picture p24: schematic mqtt_basis_pi_pico.kicad_sch]

Parts:
J2: AST041-08
K1: FINDER-40.52; Relay_DPDT_Finder_40.52
Q1: IRLML0030; SOT-23
R1: 100; R_0603_1608Metric
R2: 100k; R_0603_1608Metric
R4: R; R_0603_1608Metric
U1: Pico; RPi_Pico_SMD_TH
U2: LTV-817S; SMDIP-4_W9.53mm
U3: w5500_spi_modul
U4: MCP23017_SO; SOIC-28W_7.5x17.9mm_P1.27mm

Connections:
GND: Q1.2 (S), R2.1, U1.42 (GND), U2.3, U3.1 (GND), U3.5 (RST), U4.10 (VSS), U4.15 (A0), U4.16 (A1), U4.17 (A2)
unnamed: J2.1 (io), R4.1
unnamed: J2.8 (io), U2.2
unnamed: K1.A2, Q1.3 (D)
unnamed: Q1.1 (G), R1.2, R2.2
unnamed: R4.2, U2.1
unnamed: U1.1 (GPIO0), U2.4
unnamed: U1.6 (GPIO4), U4.13 (SDA)
unnamed: U1.7 (GPIO5), U4.12 (SCK)
unnamed: U1.21 (GPIO16), U3.6 (MI)
unnamed: U1.22 (GPIO17), U3.8 (CS)
unnamed: U1.24 (GPIO18), U3.9 (SCK)
unnamed: U1.25 (GPIO19), U3.10 (MO)
unnamed: R1.1, U4.1 (GPB0)
unnamed: U1.23 (GND), U4.18 (~RESET)
VCC: K1.A1, U3.2 (VCC), U4.9 (VDD)

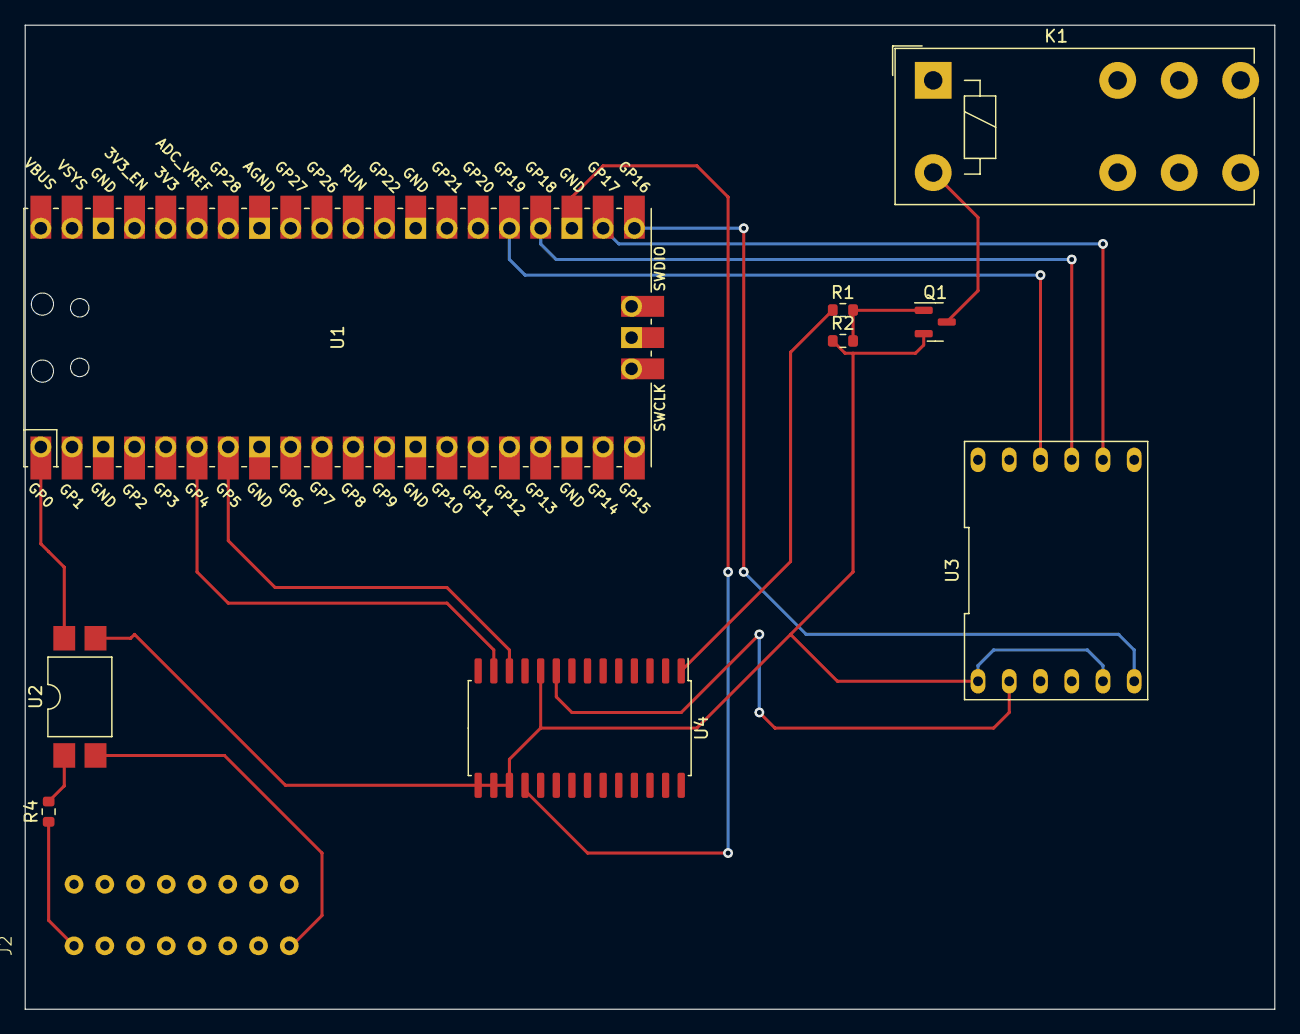
[picture p25: board mqtt_basis_pi_pico.kicad_pcb from above]

Board: 2 copper layers, 101.6 x 80.0 mm, 10 parts (0 on the bottom side), 16 nets.
