tekki-tom/mqtt_io/(commit log)

2023-03-09 erster checkin
    [mqtt_basis_pi_pico.kicad_pcb, mqtt_basis_pi_pico.kicad_sch]
2023-03-11 platine_out_23017 (i2c), smd v0.1
    [mqtt_out_box.kicad_sch]
2023-03-19 repos aufgeräumt und Dateien verschoben
    [mqtt_basis_pi_pico.kicad_pcb, mqtt_basis_pi_pico.kicad_sch, mqtt_io_inOut_8i_8o_tht.kicad_pcb, mqtt_io_inOut_8i_8o_tht.kicad_sch, mqtt_io_in_box_16i_tht.kicad_pcb, mqtt_io_in_box_16i_tht.kicad_sch, mqtt_out_box.kicad_sch, mqtt_out_box_16o.kicad_pcb]
2023-04-01 Pullup für ic2 eingefügt (4k7)
    [mqtt_basis_pi_pico.kicad_pcb, mqtt_basis_pi_pico.kicad_sch, mqtt_io_inOut_8i_8o_tht.kicad_pcb, mqtt_io_inOut_8i_8o_tht.kicad_sch, mqtt_io_in_box_16i_tht.kicad_pcb, mqtt_io_in_box_16i_tht.kicad_sch, mqtt_out_box.kicad_sch, mqtt_out_box_16o_tht.kicad_pcb]
2023-04-01 Beispiel-Code für ATMega328p / (Arduino Uno) eingefügt
2023-04-23 neue Dateien eingefügt.
    out Platine rev 2, testprogramm für pi pico
    [mqtt_io_inOut_8i_8o_smd_optp.kicad_pcb, mqtt_io_inOut_8i_8o_smd_optp.kicad_sch, mqtt_io_inOut_8i_8o_tht.kicad_pcb, mqtt_io_inOut_8i_8o_tht.kicad_sch, mqtt_io_in_box_16i_tht.kicad_pcb, mqtt_io_in_box_16i_tht.kicad_sch, mqtt_out_box.kicad_sch, mqtt_out_box_16o.kicad_pcb]
2023-06-25 Kleine Korrekturen
    [mqtt_out_box_16o_tht_rev2.kicad_pro.kicad_sch]
2023-06-30 kleine Anpassungen
    [mqtt_out_box_16o_tht_rev2.kicad_pro.kicad_sch]
2023-07-16 neue Tests für i2c Expander
    "Lauflicht" Test
    io_expander Nr beachten!
2023-09-09 Jumper, Beschriftung
    Jumper für pullupWiderstände bei SDA und SCK eingefügt. Die Widerstände
    sind nun zuschaltbar.
    Beschriftung für in SDA/SCK/GND und Spannungsversorgung angebracht.
    PDFs neu generiert.
    [mqtt_out_box_16o_tht_rev2.kicad_pro.kicad_sch]
2024-04-09 Neue Version angelegt (SMD, Opto THT)
    [mqtt_io_in_box_16i_tht_smd.csv, mqtt_io_in_box_16i_tht_smd.kicad_pcb, mqtt_io_in_box_16i_tht_smd.kicad_sch]
